laurencebarker/Andromeda_front_panel/pictures/Kjell 1st prototype/20190321_191115.jpg

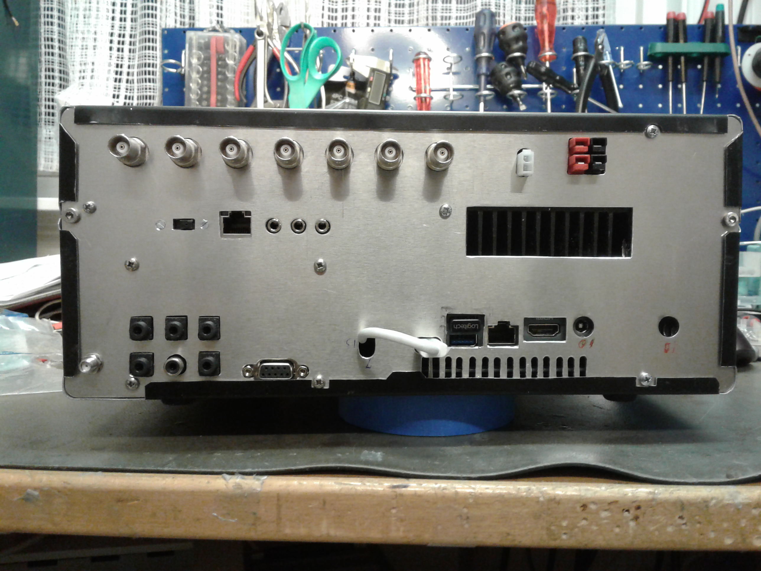
pictures/Kjell 1st prototype/20190321_191115.jpg
