laurencebarker/Andromeda_front_panel/front panel/sketch/andromeda_front_panel/readme.txt

This folder contains a sketck for a prototype of the Andromeda front panel using the ARDUINO DUE processor. 

The newer design has an Arduino Nano Every processor.

This sketch is obsolete now, and will not be maintained.
