laurencebarker/Andromeda_front_panel/front panel/documentation/Newhaven display PWM schematic.png

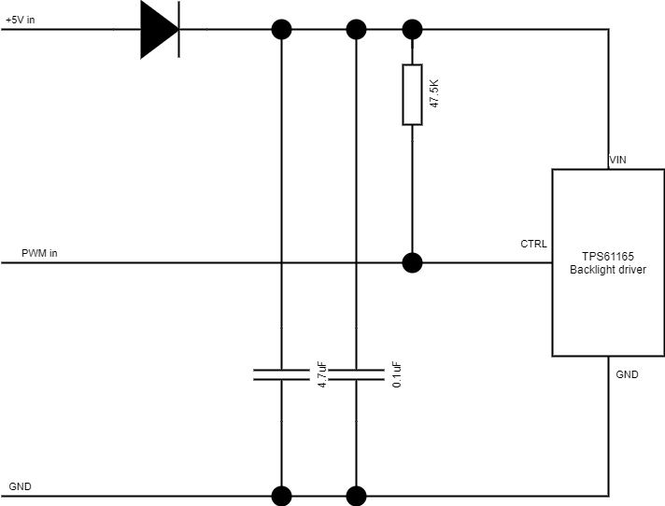
front panel/documentation/Newhaven display PWM schematic.png
