laurencebarker/Andromeda_front_panel/pictures/Kjell 1st prototype/20190321_192408.jpg

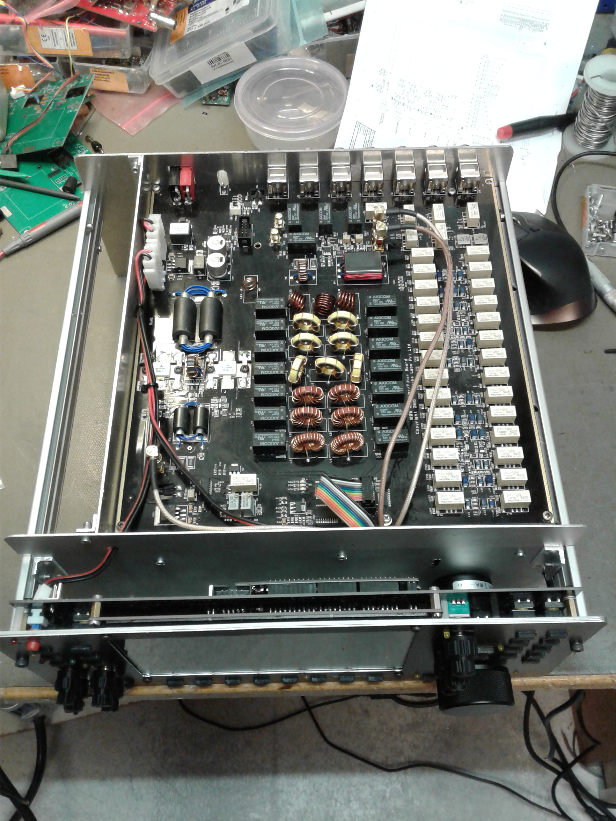
pictures/Kjell 1st prototype/20190321_192408.jpg
