laurencebarker/Andromeda_front_panel/front panel/hardware rev 5/Andromeda IO Board_ Parts_List_Nov_2019.odt

Andromeda I/O Board Parts List.

Nov. 2019

47 pcs. 10nF Size 0603

C1- C45, C47. Do not install C21, C22, C29, C30, C41

on LINE Out.

1 pcs. 2x13 26 pin Header Molex PN: 70247-2651

J1 Mouser PN: 538-70247-2651

1 pcs. 9 pin Delta Header, Female Harting PN: 09641127235 (https://www.digikey.com/product-detail/en/harting/09641127235/1195-2367-ND/3180950)

J2 DigiKey PN: 1195-2367-ND (https://www.digikey.com/product-detail/en/harting/09641127235/1195-2367-ND/3180950)

Mouser PN: 617-09-64-112-7235

1 pcs. RCA header. Pro-Signal PN: MJ-573P

J11 Farnell PN: 1267399

5 pcs. 3,5mm Stereo Jack Molex PN: 0472570001

J4-J8 Mouser PN: 538-47257-0001

DigiKey PN: WM17366-ND

1 pcs. Header1x3 Molex PN: 38-00-6293

Mouser PN: 538-38-00-6293

1 pcs. Header 1x4 Molex PN: 22-23-2042

Mouser PN: 538-22-23-2042

1 pcs. Header 2x5 10 pin header Molex PN 70246-1003

Mouser PN:538-70246-1003

26pcs. Ferrite Beads Wurth Elektronik PN: 742792514

L1-L20, L22-L27 Mouser PN: 710-742792514

DigiKey PN: 732-1643-2-ND
