laurencebarker/Andromeda_front_panel/front panel/hardware rev 5f/ANDROMEDA BOM 5F.xls

S NO. | Designator | Value | FootPrint | Qty | MFG Part No | Notes
1 | C1, C2, C3, C4, C5, C6, C7, C8, C9, C10, C11, C12, C13, C14, C15, C16, C17, C18, C22, C36 | 10NF | 805 | 20 | C0805C103K1RAC7210 | 399-17617-2-ND
2 | C19, C20, C23, C26, C29, C31, C40, C41, C42, C43, C44, C45, C46, C47 | 100NF | 805 | 14 | C0805C104M5RACTU (https://www.digikey.com/product-detail/en/kemet/C0805C104M5RACTU/399-1169-1-ND/411444) | 399-1169-1-ND (https://www.digikey.com/product-detail/en/kemet/C0805C104M5RACTU/399-1169-1-ND/411444)
3 | C21, C24, C33, C38, C48, C50 | 1uF | 805 | 6 | C0805C105K3RACTU (https://www.digikey.com/product-detail/en/kemet/C0805C105K3RACTU/399-8004-1-ND/3471727) | 399-8004-1-ND (https://www.digikey.com/product-detail/en/kemet/C0805C105K3RACTU/399-8004-1-ND/3471727)
4 | C25 | 4.7uF | 805 | 1 | CL21A475KBQNNNE (https://www.digikey.com/en/products/detail/samsung-electro-mechanics/CL21A475KBQNNNE/3886906) | 1276-1248-1-ND
5 | C27, C28 | 1NF | 805 | 2 | CC0805KRX7R9BB102 (https://www.digikey.com/product-detail/en/yageo/CC0805KRX7R9BB102/311-1127-1-ND/303037) | 311-1127-1-ND (https://www.digikey.com/product-detail/en/yageo/CC0805KRX7R9BB102/311-1127-1-ND/303037)
6 | C30 | .47uF | 805 | 1 | CC0805KKX7R8BB474 (https://www.digikey.com/product-detail/en/yageo/CC0805KKX7R8BB474/311-1364-1-ND/2103148) | 311-1364-1-ND (https://www.digikey.com/product-detail/en/yageo/CC0805KKX7R8BB474/311-1364-1-ND/2103148)
7 | C32, C34, C39, C51, C52, C53 | 10uF | 805 | 6 | GRM21BR61E106MA73L (https://www.digikey.com/product-detail/en/murata-electronics/GRM21BR61E106MA73L/490-10748-1-ND/5251352) | 490-10748-1-ND (https://www.digikey.com/product-detail/en/murata-electronics/GRM21BR61E106MA73L/490-10748-1-ND/5251352)
8 | C35 | 22uF | 2312 | 1 | T491C226M025AT (https://www.digikey.com/en/products/detail/kemet/T491C226M025AT/3724718) | 399-9736-1-ND
9 | C37 | 47uF | 2917 | 1 | T491D476K025AT (https://www.digikey.com/en/products/detail/kemet/T491D476K025AT/2336348) | 399-8391-1-ND
10 | C54 | 10uF | 1411 | 1 | T491B106M025AT (https://www.digikey.com/en/products/detail/kemet/T491B106M025AT/3724676) | 399-9721-1-ND
11 | R1 | 4K7 | 805 | 1 | RMCF0805FT4K70 (https://www.digikey.com/en/products/detail/stackpole-electronics-inc/RMCF0805FT4K70/1760659) | RMCF0805FT4K70CT-ND
12 | R2, R3, R4, R5, R6, R7, R10, R15, R16, R17, R18, R19, R20, R21, R22, R23, R24, R25, R26, R27, R28, R29, R30, R31, R32, R33, R34, R35, R36, R37, R38, R39, R40, R41, R42, R43 | 10K | 805 | 36 | RC0805FR-0710KL (https://www.digikey.com/product-detail/en/yageo/RC0805FR-0710KL/311-10-0KCRCT-ND/730482) | 311-10.0KCRCT-ND (https://www.digikey.com/product-detail/en/yageo/RC0805FR-0710KL/311-10-0KCRCT-ND/730482)
13 | R8 | 100E | 805 | 1 | CR0805-FX-1000ELF (https://www.digikey.com/en/products/detail/bourns-inc/CR0805-FX-1000ELF/3740946) | CR0805-FX-1000ELFCT-ND
14 | R9 | 470E | 805 | 1 | RC0805FR-07470RL (https://www.digikey.com/en/products/detail/yageo/RC0805FR-07470RL/727976) | 311-470CRCT-ND
15 | R12, R13, R44, R45 | 100K | 805 | 4 | RC0805FR-07100KL (https://www.digikey.com/product-detail/en/yageo/RC0805FR-07100KL/311-100KCRCT-ND/730491) | 311-100KCRCT-ND (https://www.digikey.com/product-detail/en/yageo/RC0805FR-07100KL/311-100KCRCT-ND/730491)
16 | R14 | 180K | 805 | 1 | CRGCQ0805F180K (https://www.digikey.com/product-detail/en/te-connectivity-passive-product/CRGCQ0805F180K/A129776CT-ND/8577608) | A129776CT-ND (https://www.digikey.com/product-detail/en/te-connectivity-passive-product/CRGCQ0805F180K/A129776CT-ND/8577608)
17 | R46, R47, R48, R49, R50, R51, R53, R54, R55, R56, R57, R63 | 1K2 | 805 | 11 | CRG0805F1K5 (https://www.digikey.com/product-detail/en/te-connectivity-passive-product/CRG0805F1K5/A106057CT-ND/3477701) | A106057CT-ND (https://www.digikey.com/product-detail/en/te-connectivity-passive-product/CRG0805F1K5/A106057CT-ND/3477701)
18 | R52 | 220E | 805 | 1 | RMCF0805FT220R (https://www.digikey.com/en/products/detail/stackpole-electronics-inc/RMCF0805FT220R/1760238) | RMCF0805FT220RCT-ND
19 | R59, R60 | 2K2 | 805 | 2 | RMCF0805FT2K20 (https://www.digikey.com/en/products/detail/stackpole-electronics-inc/RMCF0805FT2K20/1760345) | RMCF0805FT2K20CT-ND
20 | R61 | 620E | 805 | 1 | RMCF0805FT620R (https://www.digikey.com/en/products/detail/stackpole-electronics-inc/RMCF0805FT620R/1713293) | RMCF0805FT620RCT-ND
21 | R63 | 1K5 | 805 | 1 | RMCF0805FT1K50 (https://www.digikey.com/en/products/detail/stackpole-electronics-inc/RMCF0805FT1K50/1760652) | RMCF0805FT1K50CT-ND
22 | R62 | 3K3 | 805 | 1 | CRG0805F3K3 (https://www.digikey.com/product-detail/en/te-connectivity-passive-product/CRG0805F3K3/A106062CT-ND/3477709) | A106062CT-ND (https://www.digikey.com/product-detail/en/te-connectivity-passive-product/CRG0805F3K3/A106062CT-ND/3477709)
23 | R64 | 47E | 805 | 1 | CRG0805F47R (https://www.digikey.com/product-detail/en/te-connectivity-passive-product/CRG0805F47R/A126371CT-ND/7603426) | A126371CT-ND (https://www.digikey.com/product-detail/en/te-connectivity-passive-product/CRG0805F47R/A126371CT-ND/7603426)
24 | IC1, IC2 | MCP23017 |  | 2 | MCP23017T-E/SO | MCP23017T-E/SOCT-ND
25 | IC3 | NANO EVERY |  | 1 | ABX00033 (https://www.digikey.com/en/products/detail/arduino/ABX00033/10239972) | 1050-ABX00033-ND
26 | IC4 | LMZ22005TZ |  | 1 | LMZ22005TZX/NOPB | 296-43603-1-ND
27 | T1, T3, T4 | 2N7002K |  | 3 | 2N7002K-7 (https://www.digikey.com/product-detail/en/diodes-incorporated/2N7002K-7/2N7002K-7DICT-ND/3053305) | 2N7002K-7DICT-ND (https://www.digikey.com/product-detail/en/diodes-incorporated/2N7002K-7/2N7002K-7DICT-ND/3053305)
28 | T2 | FDD6685 |  | 1 | FDD6685 | FDD6685CT-ND
29 | ENC1, ENC3, ENC7, ENC9, ENC5, ENC11 | DUAL ENCODER |  | 6 | EC11EBB24C03 (https://au.element14.com/alps/ec11ebb24c03/encoder-dual-shaft-11mm/dp/2065025) | EC11EBB24C03 (https://au.element14.com/alps/ec11ebb24c03/encoder-dual-shaft-11mm/dp/2065025)
30 | ENC13 | HRPG-ASCA#? |  | 1 | HRPG-ASCA#19F | HRPG-ASCA#19F-ND
31 | D1, D2, D13 | RED LED |  | 3 | WP424IDT | 754-1305-ND (https://www.digikey.com/product-detail/en/kingbright/WP424IDT/754-1305-ND/1747704)
32 | D3, D6, D7, D9, D10, D11, D12 | YELLOW LED |  | 7 | WP424YDT | 754-1306-ND (https://www.digikey.com/product-detail/en/kingbright/WP424YDT/754-1306-ND/1747705)
33 | D4, D5 | GREEN LED |  | 2 | WP424GDT | 754-1304-ND (https://www.digikey.com/product-detail/en/kingbright/WP424GDT/754-1304-ND/1747703)
34 | D14 | BAS16J |  | 1 | BAS16J,115 (https://www.digikey.com/product-detail/en/nexperia-usa-inc/BAS16J-115/1727-6169-1-ND/2762666) | 1727-6169-1-ND (https://www.digikey.com/product-detail/en/nexperia-usa-inc/BAS16J-115/1727-6169-1-ND/2762666)
35 | L1-L13 | FERRITE BEAD |  | 13 | 742792514 | 732-1643-1-ND
36 | SW1-SW31 | TACTILE SWITCH |  | 31 | TL3301SPF160QG | EG1869TR-ND
37 | J1 | MIC/RJ45 |  | 1 | SS-7188V-A-NF-50 | SS-7188V-A-NF-50-ND
38 | J2, J7 | 10 PIN HEADER |  | 2 | 302-S101 | ED1543-ND (https://www.digikey.com/product-detail/en/on-shore-technology-inc/302-S101/ED1543-ND/2178422)
39 | J3 | USB-A |  | 1 | 1002-021-01000 | 1175-1265-ND
40 | J4 | USB-B |  | 1 | UJ2-BV-1-TH | 102-4000-ND
41 | J5, J6 | AUDIO |  | 2 | STX-3790-5N | 2092-STX-3790-5N-ND
42 | J8, J9, J10, J13, J14, J15, J16 | 2 PIN BERG |  | 7
43 | J11 | 4 PIN HEADER |  | 1
44 | J12, J17, J18 | 3 PIN HEADER |  | 3
45 | J16
