laurencebarker/Andromeda_front_panel/front panel/hardware/Andromeda CAT Console_rev3_BOM.odt

ULTIboard V5.71 Date : 04 May 2019 Time 18:23

File name :

---- List of Components ----

Name | Alias | Shape Comments

C1 = 100N : (C0805_W)

C2 = 1U : (C0805_W)

C3 = 100N : (C0805_W)

C4 = 10N : (C0805_W)

C5 = 100N : (C0805_W)

C6 = 100N : (C0805_W)

C7 = 10U : (C0805_W)

C8 = 100N : (C0805_W)

C9 = 1N : (C0805_W)

C10 = 100N : (C0805_W)

C11 = 100N : (C0805_W)

C12 = 100N : (C0805_W)

C13 = 100N : (C0805_W)

C14 = 10N : (C0805_W)

C15 = 10N : (C0805_W)

C16 = 10N : (C0805_W)

C17 = 10N : (C0805_W)

C18 = 10N : (C0805_W)

C19 = 10N : (C0805_W)

C20 = 10N : (C0805_W)

C21 = 10N : (C0805_W)

C22 = 10N : (C0805_W)

C23 = 10N : (C0805_W)

C24 = 10N : (C0805_W)

C25 = 10N : (C0805_W)

C26 = 10N : (C0805_W)

C27 = 10N : (C0805_W)

C28 = 10N : (C0805_W)

C29 = 10N : (C0805_W)

C30 = 10N : (C0805_W)

C31 = 10N : (C0805_W)

C32 = 100N : (C0805_W)

C33 = 100N : (C0805_W)

D1 = LED : (LED3R2_5V) 3mm diameter

D2 = LED : (LED3R2_5V) 3mm diameter

D3 = LED : (LED3R2_5V) 3mm diameter

D4 = LED : (LED3R2_5V) 3mm diameter

D5 = LED : (LED3R2_5V) 3mm diameter

D6 = LED : (LED3R2_5V) 3mm diameter

D7 = LED : (LED3R2_5V) 3mm diameter

D8 = LED : (LED3R2_5V) 3mm diameter

D9 = LED : (LED3R2_5V) 3mm diameter

D10 = LED_1 : (LED3R2_5V!1) 3mm diameter

D11 = LED : (LED3R2_5V) 3mm diameter

D12 = LED : (LED3R2_5V) 3mm diameter

D13 = LED : (LED3R2_5V) 3mm diameter

DISP1 = : (7INCH_DISPLAY!0)

DUE = : (ARDUINO_DUE)

ENC1 = HDR_5 Rotary Encoder PN:HN3808-AB-400N

Alternative PN: PNLPD 38006-600BM-24C

Alternative PN: PNG40B-6-400-2-24

+ several other.

ULTIboard V5.71 Date : 04 May 2019 Time 18:23

File name :

---- List of Components ----

Name | Alias | Shape Comments

ENC2 = - : (EC11) Dual encoder ALPS PN:EC11EBB24C03 Farnell

ENC3 = - : (EC11) Dual encoder ALPS PN:EC11EBB24C03 Farnell

ENC4 = - : (EC11) Dual encoder ALPS PN:EC11EBB24C03 Farnell

ENC5 = : (EC11) Single encoder ALPS PN:EC12E2420A2 Farnell

ENC6 = - : (EC11) Dual encoder ALPS PN:EC11EBB24C03 Farnell

ENC7 = : (EC11) Single encoder ALPS PN:EC12E2420A2 Farnell

IC1 = - : ($SO28S) MCP23017

J1 = DIGITAL : (HDR2X18) Header, Male, 2x18 pins

J2 = PWMH : (HDR1X10) Header, Male 1x10 pins

J3 = PWML : (HDR1X8) Header, Male 1x8 pins

J4 = COMMUNICATION : (HDR1X8) Header, Male 1x8 pins

J5 = POWER : (HDR1X8) Header, Male 1x8 pins

J6 = ANALOG_IN : (HDR1X8) Header, Male 1x8 pins

J7 = ADCH : (HDR1X8) Header, Male 1x8 pins

J8 = HDR_2 : (HDR1X2) Header, Male 1x2 pins

J9 = HDR_3 : (HEADER1X3) Header, Male 1x3 pins

J10 = HDR_10 : (HDR2X5) Header, Male 2x5 pins

J11 = HDR_2 : (HDR1X2) Header, Male 1x2 pins

J12 = HDR_10 : (RJ45!0) RJ45 PN:AE10392-ND Prod:Assman DigiKey

J13 = HDR_10 : (HDR2X5) Header, Male, 2x5 pins

J14 = HDR_6 : (USB_A_V) PN:1002-021-01000 Prod CnCTech DigiKey

Alt PN:RND 205-00660 Prod: RND Elfa Distrelec

J15 = HDR_6 : (HDR2X3) Header. Male 2x3

J16 = HDR_4 : (MOLEX_WM17) 3,5 mm Stereo Jack PN:47257-0001 DigiKey

J17 = HDR_4 : (MOLEX_WM17) 3,5 mm Stereo Jack PN:47257-0001 DigiKey

J18 = HDR_10 : (HDR2X5) Header, Male 2x5 Pins

J19 = HDR_2 : (HDR1X2) Header, Male 1x2 Pins

J20 = HDR_2 : (HDR1X2) Header, Male 1x2 Pins

L1 = FERR_B : (TAN_A_W) Ferrite Bead, PN:742792514 (https://www.digikey.com/product-detail/en/wurth-electronics-inc/742792514/732-1643-2-ND/1639047) Prod:Wurth DigiKey

L2 = FERR_B : (TAN_A_W) Ferrite Bead, PN:742792514 (https://www.digikey.com/product-detail/en/wurth-electronics-inc/742792514/732-1643-2-ND/1639047) Prod:Wurth DigiKey

L3 = FERR_B : (TAN_A_W) Ferrite Bead, PN:742792514 (https://www.digikey.com/product-detail/en/wurth-electronics-inc/742792514/732-1643-2-ND/1639047) Prod:Wurth DigiKey

L4 = FERR_B : (TAN_A_W) Ferrite Bead, PN:742792514 (https://www.digikey.com/product-detail/en/wurth-electronics-inc/742792514/732-1643-2-ND/1639047) Prod:Wurth DigiKey

L5 = FERR_B : (TAN_A_W) Ferrite Bead, PN:742792514 (https://www.digikey.com/product-detail/en/wurth-electronics-inc/742792514/732-1643-2-ND/1639047) Prod:Wurth DigiKey

L6 = FERR_B : (TAN_A_W) Ferrite Bead, PN:742792514 (https://www.digikey.com/product-detail/en/wurth-electronics-inc/742792514/732-1643-2-ND/1639047) Prod:Wurth DigiKey

L7 = FERR_B : (TAN_A_W) Ferrite Bead, PN:742792514 (https://www.digikey.com/product-detail/en/wurth-electronics-inc/742792514/732-1643-2-ND/1639047) Prod:Wurth DigiKey

L8 = FERR_B : (TAN_A_W) Ferrite Bead, PN:742792514 (https://www.digikey.com/product-detail/en/wurth-electronics-inc/742792514/732-1643-2-ND/1639047) Prod:Wurth DigiKey

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

SW34 = - : (SPSD_6X6) PN:TL3301SPF260QG Prod: E_Switch DigiKey

SW35 = - : (SPSD_6X6) PN:TL3301SPF260QG Prod: E_Switch DigiKey

SW36 = - : (SPSD_6X6) PN:TL3301SPF260QG Prod: E_Switch DigiKey

SW37 = - : (SPSD_6X6) PN:TL3301SPF260QG Prod: E_Switch DigiKey

SW38 = - : (SPSD_6X6) PN:TL3301SPF260QG Prod: E_Switch DigiKey

SW39 = - : (SPSD_6X6) PN:TL3301SPF260QG Prod: E_Switch DigiKey

SW41 = - : (SPSD_6X6) PN:TL3301SPF260QG Prod: E_Switch DigiKey

SW42 = - : (SPSD_6X6) PN:TL3301SPF260QG Prod: E_Switch DigiKey

SW43 = - : (SPSD_6X6) PN:TL3301SPF260QG Prod: E_Switch DigiKey

SW44 = - : (SPSD_6X6) PN:TL3301SPF260QG Prod: E_Switch DigiKey

SW45 = - : (SPSD_6X6) PN:TL3301SPF260QG Prod: E_Switch DigiKey

SW46 = - : (PBSW!0) PN:B3F-4050 Prod: OMRON DigiKey

SW48 = - : (PBSW!0) PN:B3F-4050 Prod: OMRON DigiKey

SW49 = - : (PBSW!0) PN:B3F-4050 Prod: OMRON DigiKey

SW50 = - : (PBSW!0) PN:B3F-4050 Prod: OMRON DigiKey

SW51 = - : (SPSD_6X6) PN:TL3301SPF260QG Prod: E_Switch DigiKey

SW53 = - : (SPSD_6X6) PN:TL3301SPF260QG Prod: E_Switch DigiKey

SW54 = - : (SPSD_6X6) PN:TL3301SPF260QG Prod: E_Switch DigiKey

SW55 = - : (SPSD_6X6) PN:TL3301SPF260QG Prod: E_Switch DigiKey

SW56 = - : (PBSW!0) PN:B3F-4050 Prod: OMRON DigiKey

SW58 = - : (PBSW!0) PN:B3F-4050 Prod: OMRON DigiKey

SW59 = - : (PBSW!0) PN:B3F-4050 Prod: OMRON DigiKey

SW60 = - : (SPSD_6X6) PN:TL3301DF160QG Prod: E_Switch DigiKey

SW61 = - : (SPSD_6X6) PN:TL3301DF160QG Prod: E_Switch DigiKey

SW62 = - : (SPSD_6X6) PN:TL3301DF160QG Prod: E_Switch DigiKey

SW63 = - : (PBSW!0) PN:B3F-4050 Prod: OMRON DigiKey

SW64 = - : (SPSD_6X6) PN:TL3301DF160QG Prod: E_Switch DigiKey

T1 = 2N7002K_T/R : ($FET_2N7002!0)
