laurencebarker/Andromeda_front_panel/front panel/documentation/thetis fast tune calculator.xlsx

Variable rate encoder
encoder pulses per second | 480
update rate | 20 | ms
turn rate | 1 | rev/sec
steps/tick | 9.6
a | 0.8
b | 0.04
c | 0.005
X | Y |  | Y=ax+bx2
0 | 0
1 | 1
2 | 2
3 | 3
4 | 4
5 | 6
6 | 7
7 | 9
8 | 12
9 | 14
10 | 17
11 | 20
12 | 24
12 | 24
13 | 28
14 | 33
15 | 38
16 | 44
17 | 50
18 | 57
19 | 64
20 | 72
