laurencebarker/Andromeda_front_panel/(threads)

Thread 1 (2019-12-01):

Great project!

UN7RX, 2019-12-01:
Sorry, but I just could not thank Lawrence G8NJJ and you, Kjell LA2NI, for your beautiful designs!
I don’t understand why so few hams know about them, this is a wonderful job! Many thanks!

UN7RX, 2019-12-14:
My DDU DUC transceiver does not support Thetis, I use PowerSDR. There fore, I will use the option with Arduino DUE and version 2 or 3. There is a very useful thing in the Odin project - the Nextion display. Can I turn on the display in the Andromeda project in any way?

hb9trt, 2022-04-05:
Hi Robert,
I tried to send you an email, but I could not find any. So I try to explain something about the andromeda controller. It's not possible to use a Nextion with the andromeda controller, because this controller has no own gui. It's "only" a translation from the panel emelments (knobs, encoders) to CAT commands which can only be decoded with the latest Thetis version. The display, which you can see in different projects is connected by HDMI with an internal PC in the TRX (for example an INtel NUC). Also the touchscreen is connected directly with USB to the PC. So no signals (Video and Touch) is conneced with the andreomeda controllers arduino. The only connection to the display is the PWM entry for controlling the brightness. So it makes no sense to connect an Nextion display to this project.
I made a complete TRX built from an Odyssey-2 DDC/DUC with a HFPU 100, some transverters for higher Bands and an internal I7 NUC. Jörg Saure shows my project on his website if you would like to see more.

https://saure.org/cq-nrw/2021/05/29/odyssey-2-eigenbau-mit-andromeda-frontpanel-von-reto-hb9trt/

If you have an DDC/DUC not working with Thetis, the andromeda project cannot be used.

Thread 2 (2019-12-02):

PCB editor

UN7RX, 2019-12-02:
Good day In which program was the circuit board developed? Can I see the source code? I want to slightly change the location of the components.
When importing gerber, some of the information is lost ((

Thread 3 (2020-02-27):

PCB for Andromeda SDR Radio_v3.fpd

DH1KLM, 2020-02-27:
It's more of a request than an issue.
Are there also matching Gerber files (nothing found) for the Andromeda SDR Radio_v3.fpd front panel,
like it is in harware rev 4. I also could not find a matching Andromeda SDR Radio_v5.fpd for Andromeda Front Panel Rev5e_060220.

Please help.
Thank you

Closed 2020-03-17.

Thread 4 (2020-12-16):

Thanks for this interesting Project

hb9trt, 2020-12-16:
I would like to test if the Andromeda frontpanel works together with my former built Odyssey-2. I think it will work.

So I tried to compile the Sketch for Arduino Nano Every and got some errors:

'class PORTCClass' has no member named 'IN'

the whole error output of the compiler is here:

sketch\opticalencoder.cpp: In function 'void InitOpticalEncoder()':
opticalencoder.cpp:68:22: error: 'class PORTCClass' has no member named 'IN'
   GPinState = (PORTC.IN & VENCODERPINS) >> 2;           // bits 3:2
                      ^~
opticalencoder.cpp:76:9: error: 'class PORTCClass' has no member named 'PIN4CTRL'
   PORTC.PIN4CTRL = (PORT_PULLUPEN_bm | PORT_ISC_BOTHEDGES_gc);            // pullup, both edges interrupt
         ^~~~~~~~
opticalencoder.cpp:77:9: error: 'class PORTCClass' has no member named 'PIN5CTRL'
   PORTC.PIN5CTRL = (PORT_PULLUPEN_bm | PORT_ISC_BOTHEDGES_gc);            // pullup, both edges interrupt
         ^~~~~~~~
sketch\opticalencoder.cpp: In function 'void __vector_24()':
opticalencoder.cpp:102:23: error: 'class PORTCClass' has no member named 'IN'
   InputValue = (PORTC.IN & VENCODERPINS) >> 2;            // bits 3:2
                       ^~
opticalencoder.cpp:103:9: error: 'class PORTCClass' has no member named 'INTFLAGS'
   PORTC.INTFLAGS = 0b00110000;                            // clear interrupt flags
         ^~~~~~~~
sketch\tiger.cpp:48:1: warning: narrowing conversion of '10000000000' from 'long long int' to 'long int' inside { } [-Wnarrowing]
 };
 ^
sketch\tiger.cpp:48:1: warning: overflow in implicit constant conversion [-Woverflow]
sketch\tiger.cpp:48:1: warning: narrowing conversion of '100000000000' from 'long long int' to 'long int' inside { } [-Wnarrowing]
sketch\tiger.cpp:48:1: warning: overflow in implicit constant conversion [-Woverflow]
sketch\tiger.cpp:48:1: warning: narrowing conversion of '1000000000000' from 'long long int' to 'long int' inside { } [-Wnarrowing]
sketch\tiger.cpp:48:1: warning: overflow in implicit constant conversion [-Woverflow]
sketch\tiger.cpp:48:1: warning: narrowing conversion of '10000000000000' from 'long long int' to 'long int' inside { } [-Wnarrowing]
sketch\tiger.cpp:48:1: warning: overflow in implicit constant conversion [-Woverflow]
sketch\tiger.cpp:67:1: warning: ISO C++ forbids converting a string constant to 'char*' [-Wwrite-strings]
 };
 ^
sketch\tiger.cpp:67:1: warning: ISO C++ forbids converting a string constant to 'char*' [-Wwrite-strings]
sketch\tiger.cpp:67:1: warning: ISO C++ forbids converting a string constant to 'char*' [-Wwrite-strings]
sketch\tiger.cpp:67:1: warning: ISO C++ forbids converting a string constant to 'char*' [-Wwrite-strings]
sketch\tiger.cpp:67:1: warning: ISO C++ forbids converting a string constant to 'char*' [-Wwrite-strings]
sketch\tiger.cpp:67:1: warning: ISO C++ forbids converting a string constant to 'char*' [-Wwrite-strings]
sketch\tiger.cpp:67:1: warning: ISO C++ forbids converting a string constant to 'char*' [-Wwrite-strings]
exit status 1
'class PORTCClass' has no member named 'IN'

there are also some other errors. I think I did something wrong, but I don' know what. I added the Libraries 'DueFlashStorage', Encoder, DueTimer.

But I'm not sure if this is only for Arduiono Due. Also the standard library wire.h isn't installed, which should be installed if the board (here the Arduino Nano Every) is installed.

vy 73
Reto

hb9trt, 2020-12-16:
If I coment out some parts of the code in opticalencoder.cpp the project can be compiled.

#ifdef HIRESOPTICALENCODER
  PORTC.PIN4CTRL = (PORT_PULLUPEN_bm | PORT_ISC_RISING_gc);               // pullup, rising edge interrupt
#else
  // for low res (Broadcom type) encoders, get an interrupt on every edge
**//  PORTC.PIN4CTRL = (PORT_PULLUPEN_bm | PORT_ISC_BOTHEDGES_gc);**            // pullup, both edges interrupt
**//  PORTC.PIN5CTRL = (PORT_PULLUPEN_bm | PORT_ISC_BOTHEDGES_gc);**            // pullup, both edges interrupt
#endif
}

//
// VFO encoder pin interrupt handler
// this works one of two ways depending on the attached encoder
// for a broadcom type encoder - use both edges; find 4 bits from 2 bits current state and 2 bits previous state, and look up
// for a high res encoder at just one interrupt per pulse - use int on one edge and use the sense of the other to set direction.
//
ISR(PORTC_PORT_vect)
{
  byte InputValue;
  signed char Increment;

#ifdef HIRESOPTICALENCODER                                // on interrupt - read the non interrupting pin to set direction
  InputValue = PORTC.IN & VENCODERDIRPIN;
  PORTC.INTFLAGS = 0b00010000;                            // clear interrupt flags
  if (InputValue)
    Increment = 1;
  else
    Increment = -1;
#else
  **//  InputValue = (PORTC.IN & VENCODERPIN) >> 2;**            // bits 3:2
  **//  PORTC.IN = 0b00110000;**                            // clear interrupt flags
  GPinState = (GPinState >> 2) | InputValue;              // now have new bits in 3:2, old bits in 1:0
  Increment = StepsLookup[GPinState];
#endif

If I'm a better programmer... I could find the reason.

vy 73
Reto

Thread 6 (2022-04-04):

Type Arduino

UN7RX, 2022-04-04:
Is it possible to replace Arduino Nano Every with another type of arduino? Arduino Mega, Arduino nano, Arduino Mini, Arduino Uno? I have a big problem with acquiring Every ((

Thanks!

hb9trt, 2022-04-04:
I think basically this should work, but you have to modify the sketch to the used arduino. Also the footprint of the arduino should be the same as the every, because it will bi plugged in to the andromeda board. If you take a mega you have to wire all manualy.
But the best thing will be to have a look after an every. So you can be sure, that all works well. Also the timings could be a problem, if you take another version arduino, but I'm not sure if this is really problematic here.
