laurencebarker/Andromeda_front_panel/front panel/hardware rev 5f/Andromeda Front Panel Rev5f_02_11_20.pdf

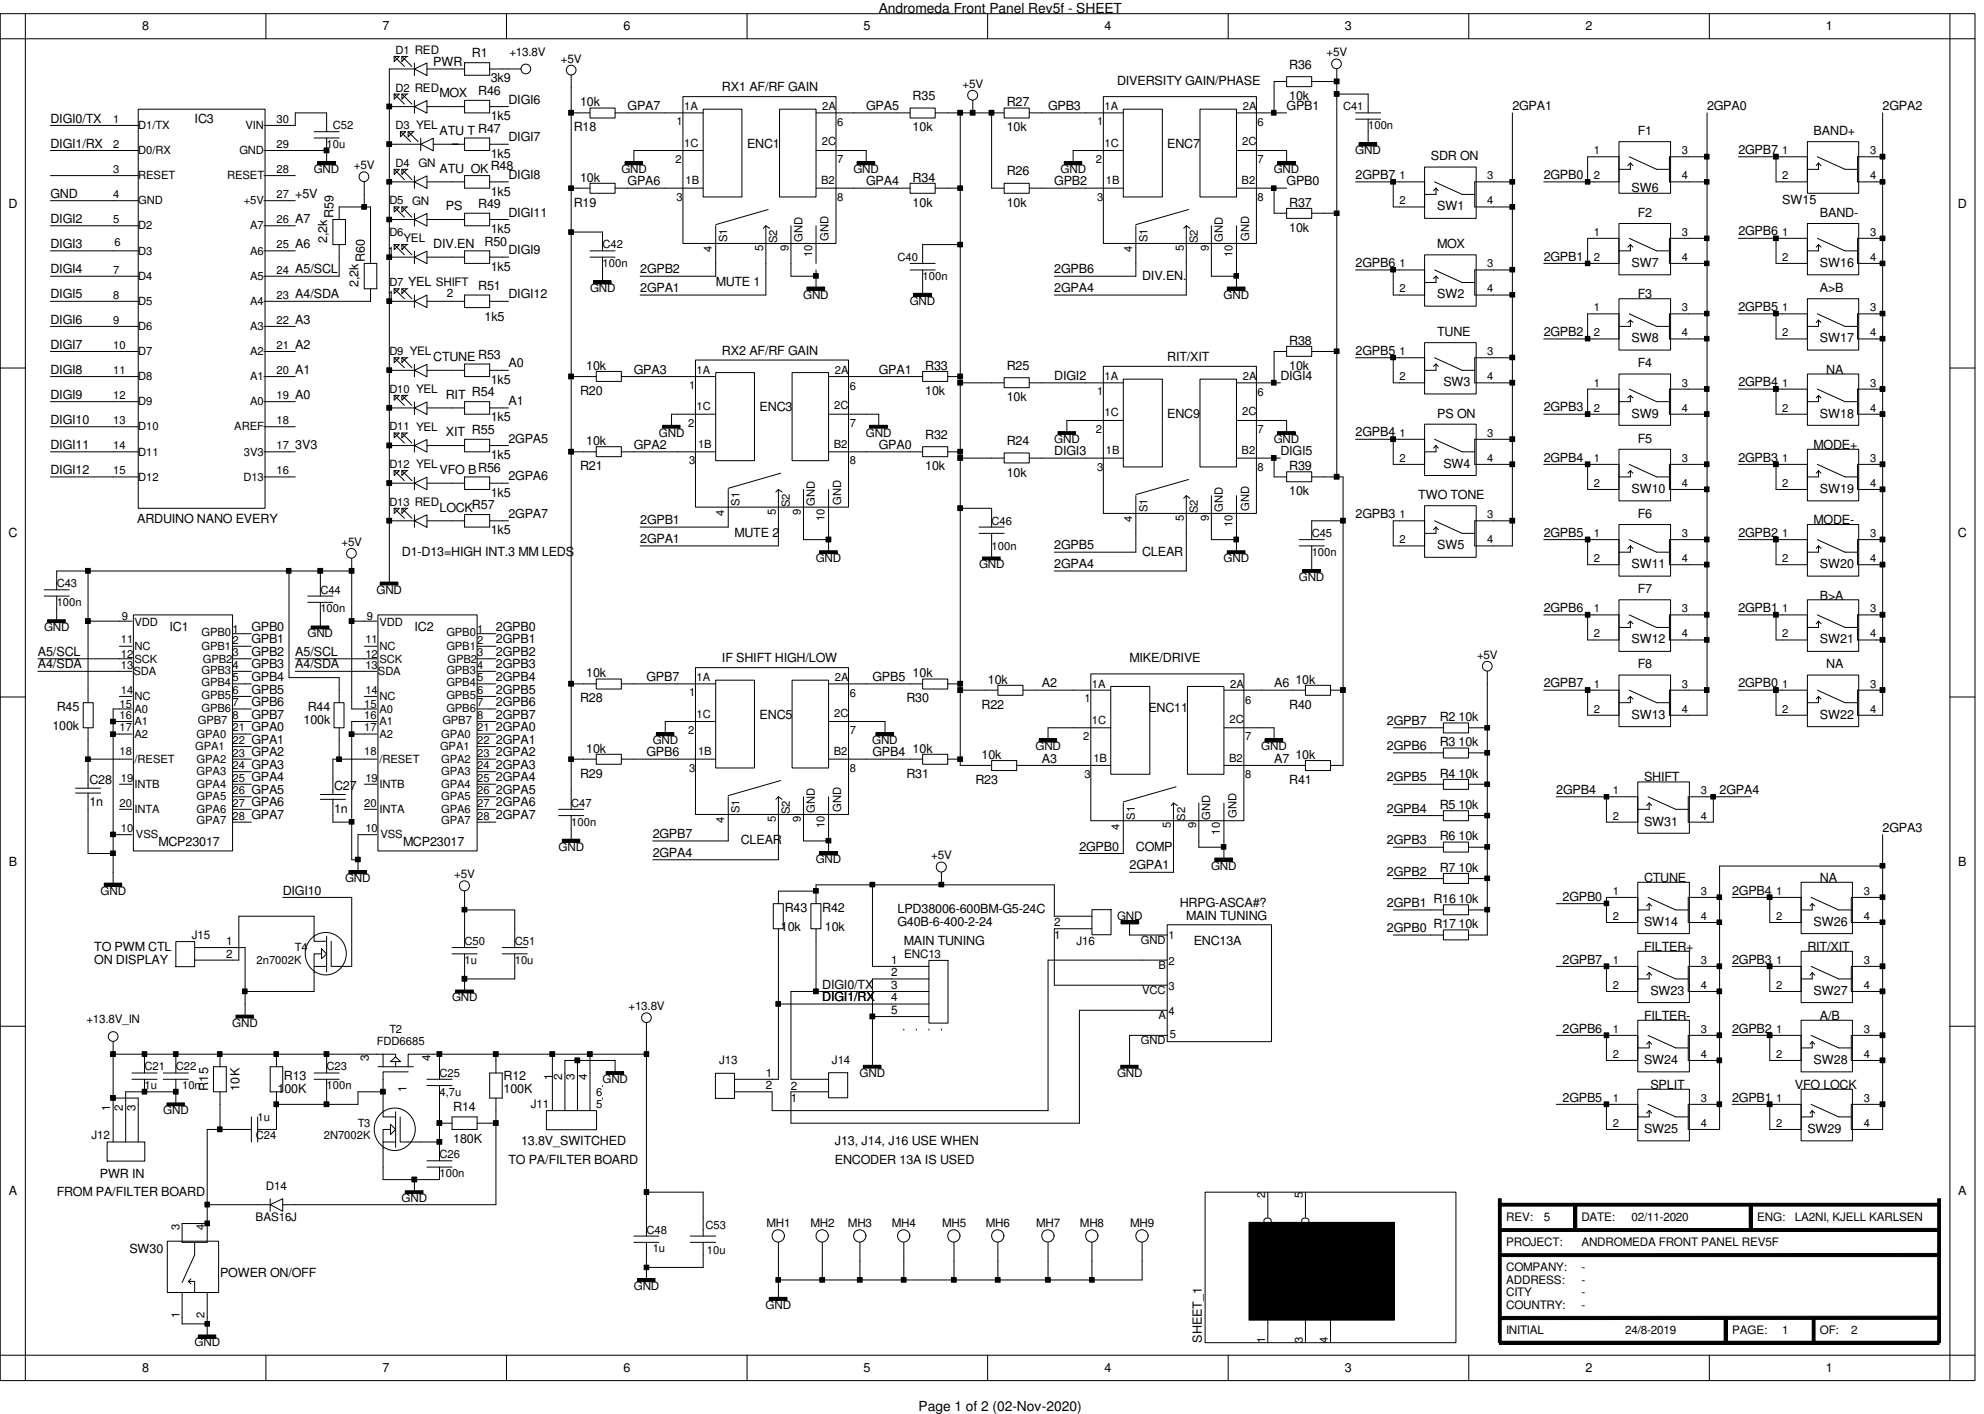
[picture p17: page 1]

Andromeda Front Panel Rev5f - SHEET

D1-D13=HIGH INT.3 MM LEDS

13.8V_SWITCHED
TO PA/FILTER BOARD

FROM PA/FILTER BOARD

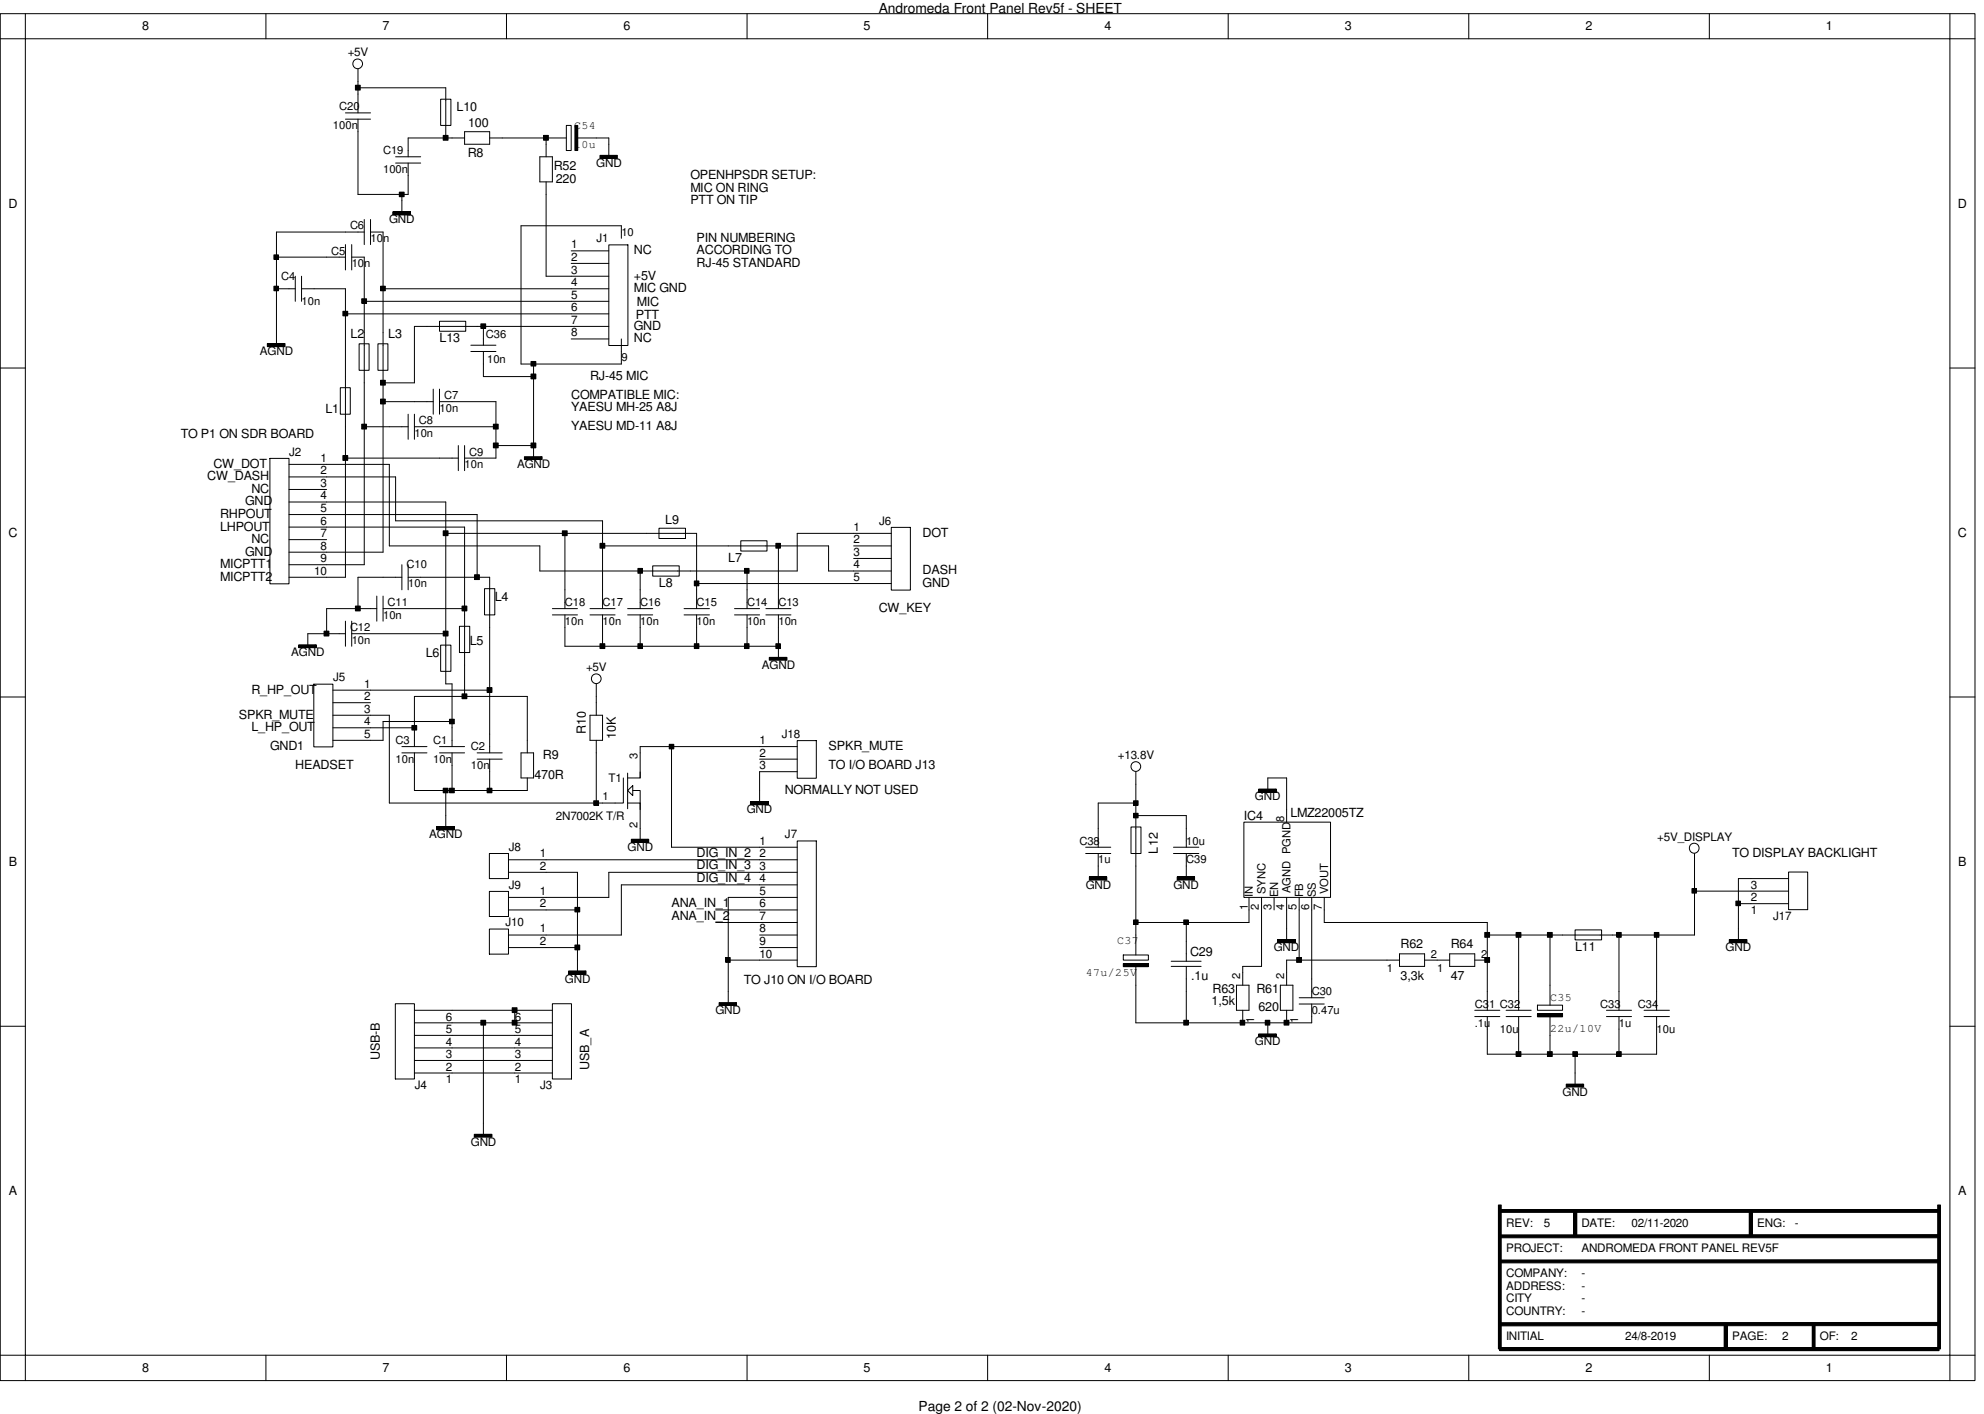
[picture p18: page 2]

Andromeda Front Panel Rev5f - SHEET

TO P1 ON SDR BOARD
