laurencebarker/Andromeda_front_panel/front panel/hardware rev 5/Andromeda Front Panel_Schematics_ Rev5e_06_.pdf

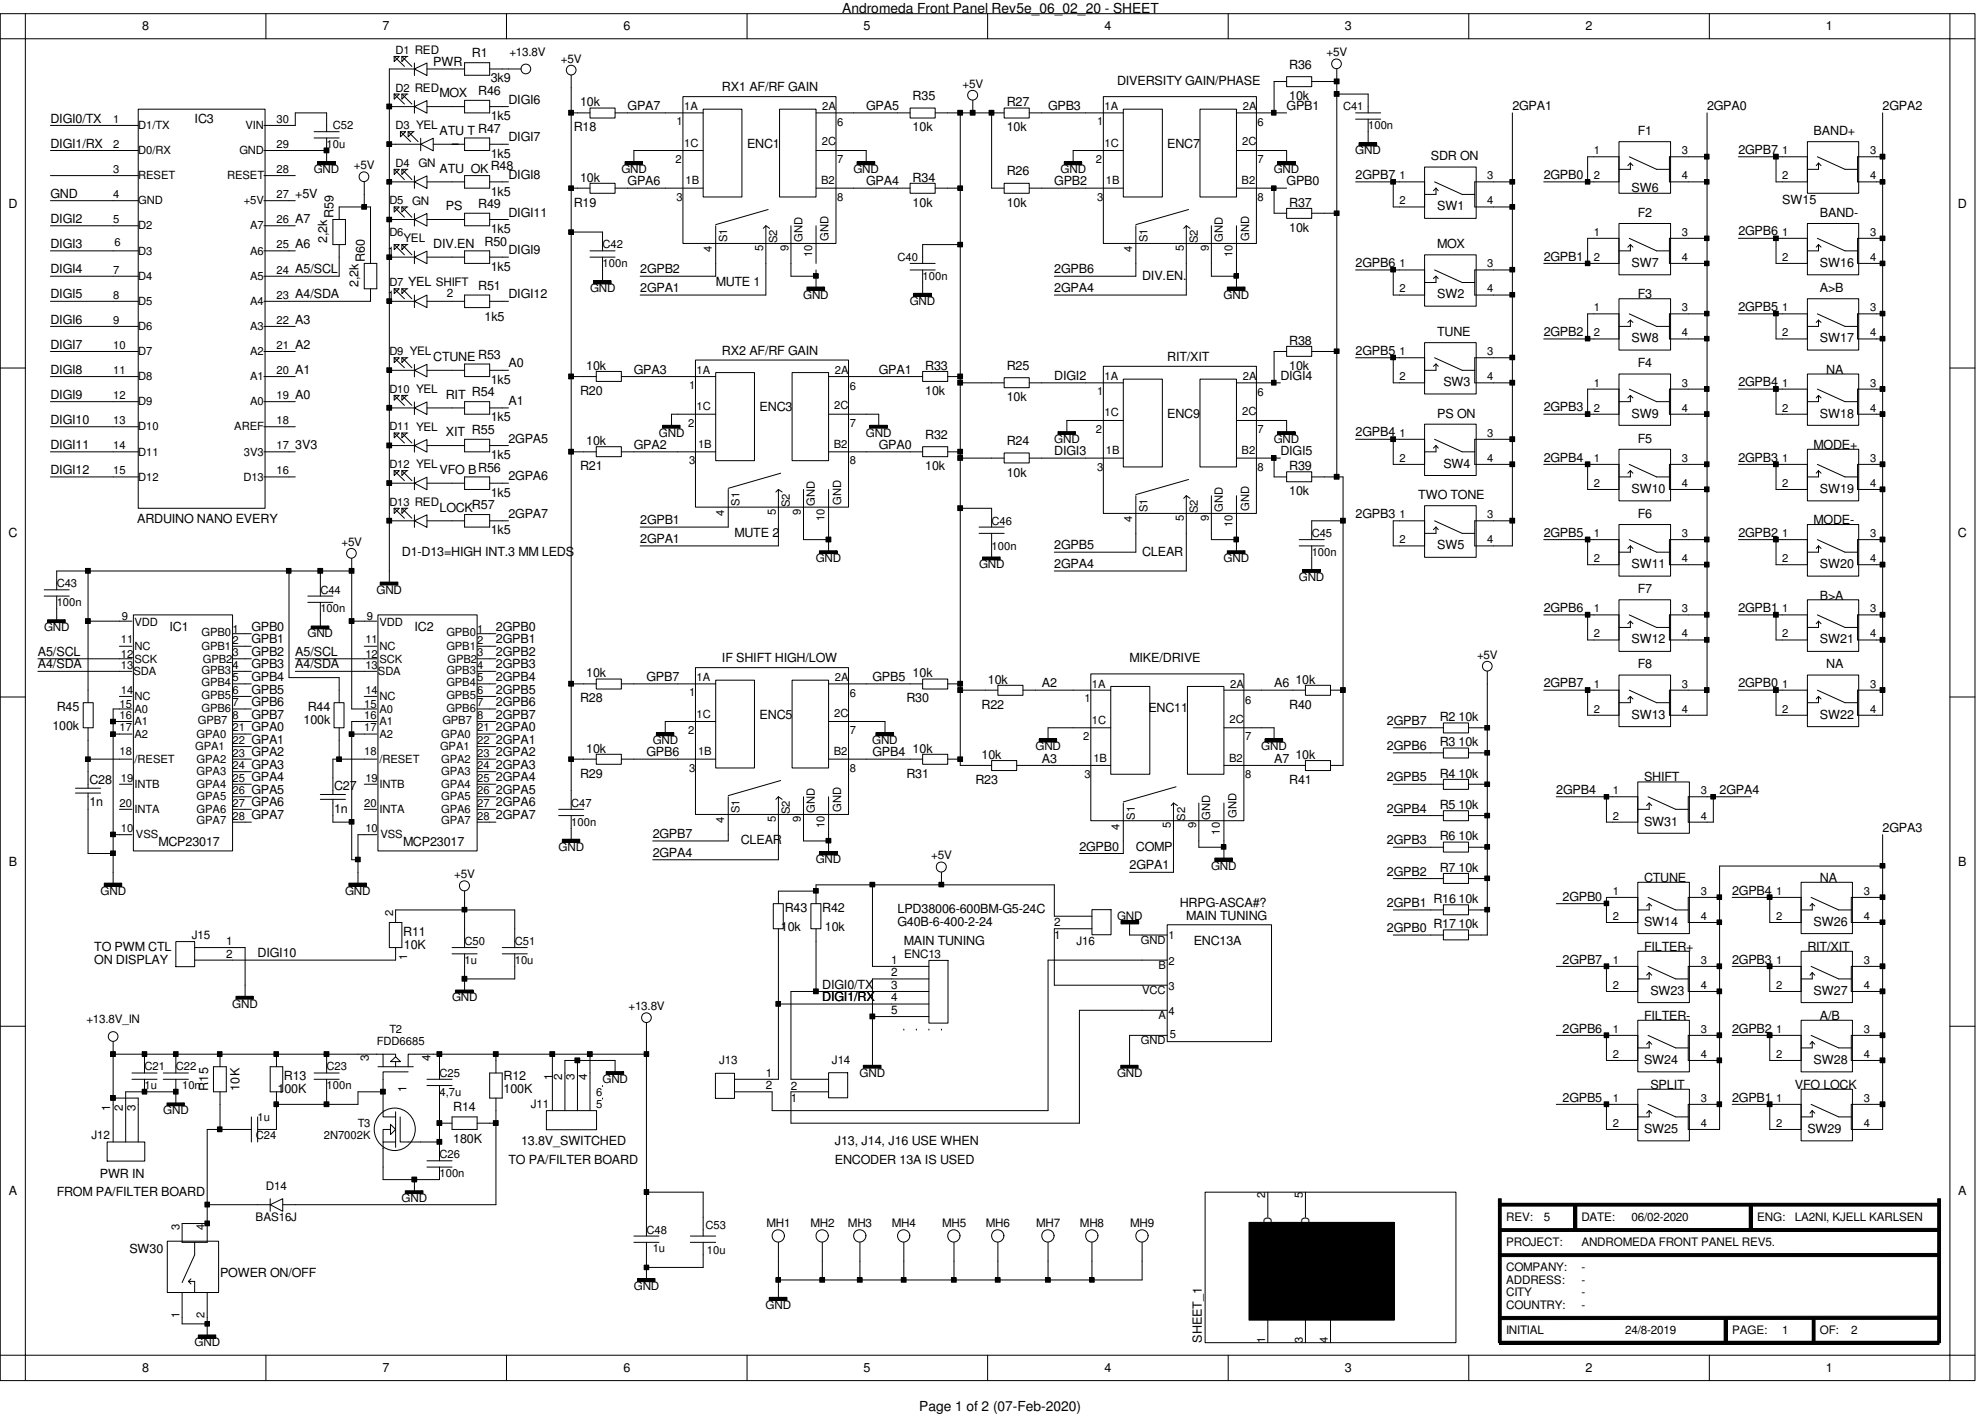
[picture p19: page 1]

Andromeda Front Panel Rev5e_06_02_20 - SHEET

D1-D13=HIGH INT.3 MM LEDS

13.8V_SWITCHED
TO PA/FILTER BOARD

FROM PA/FILTER BOARD

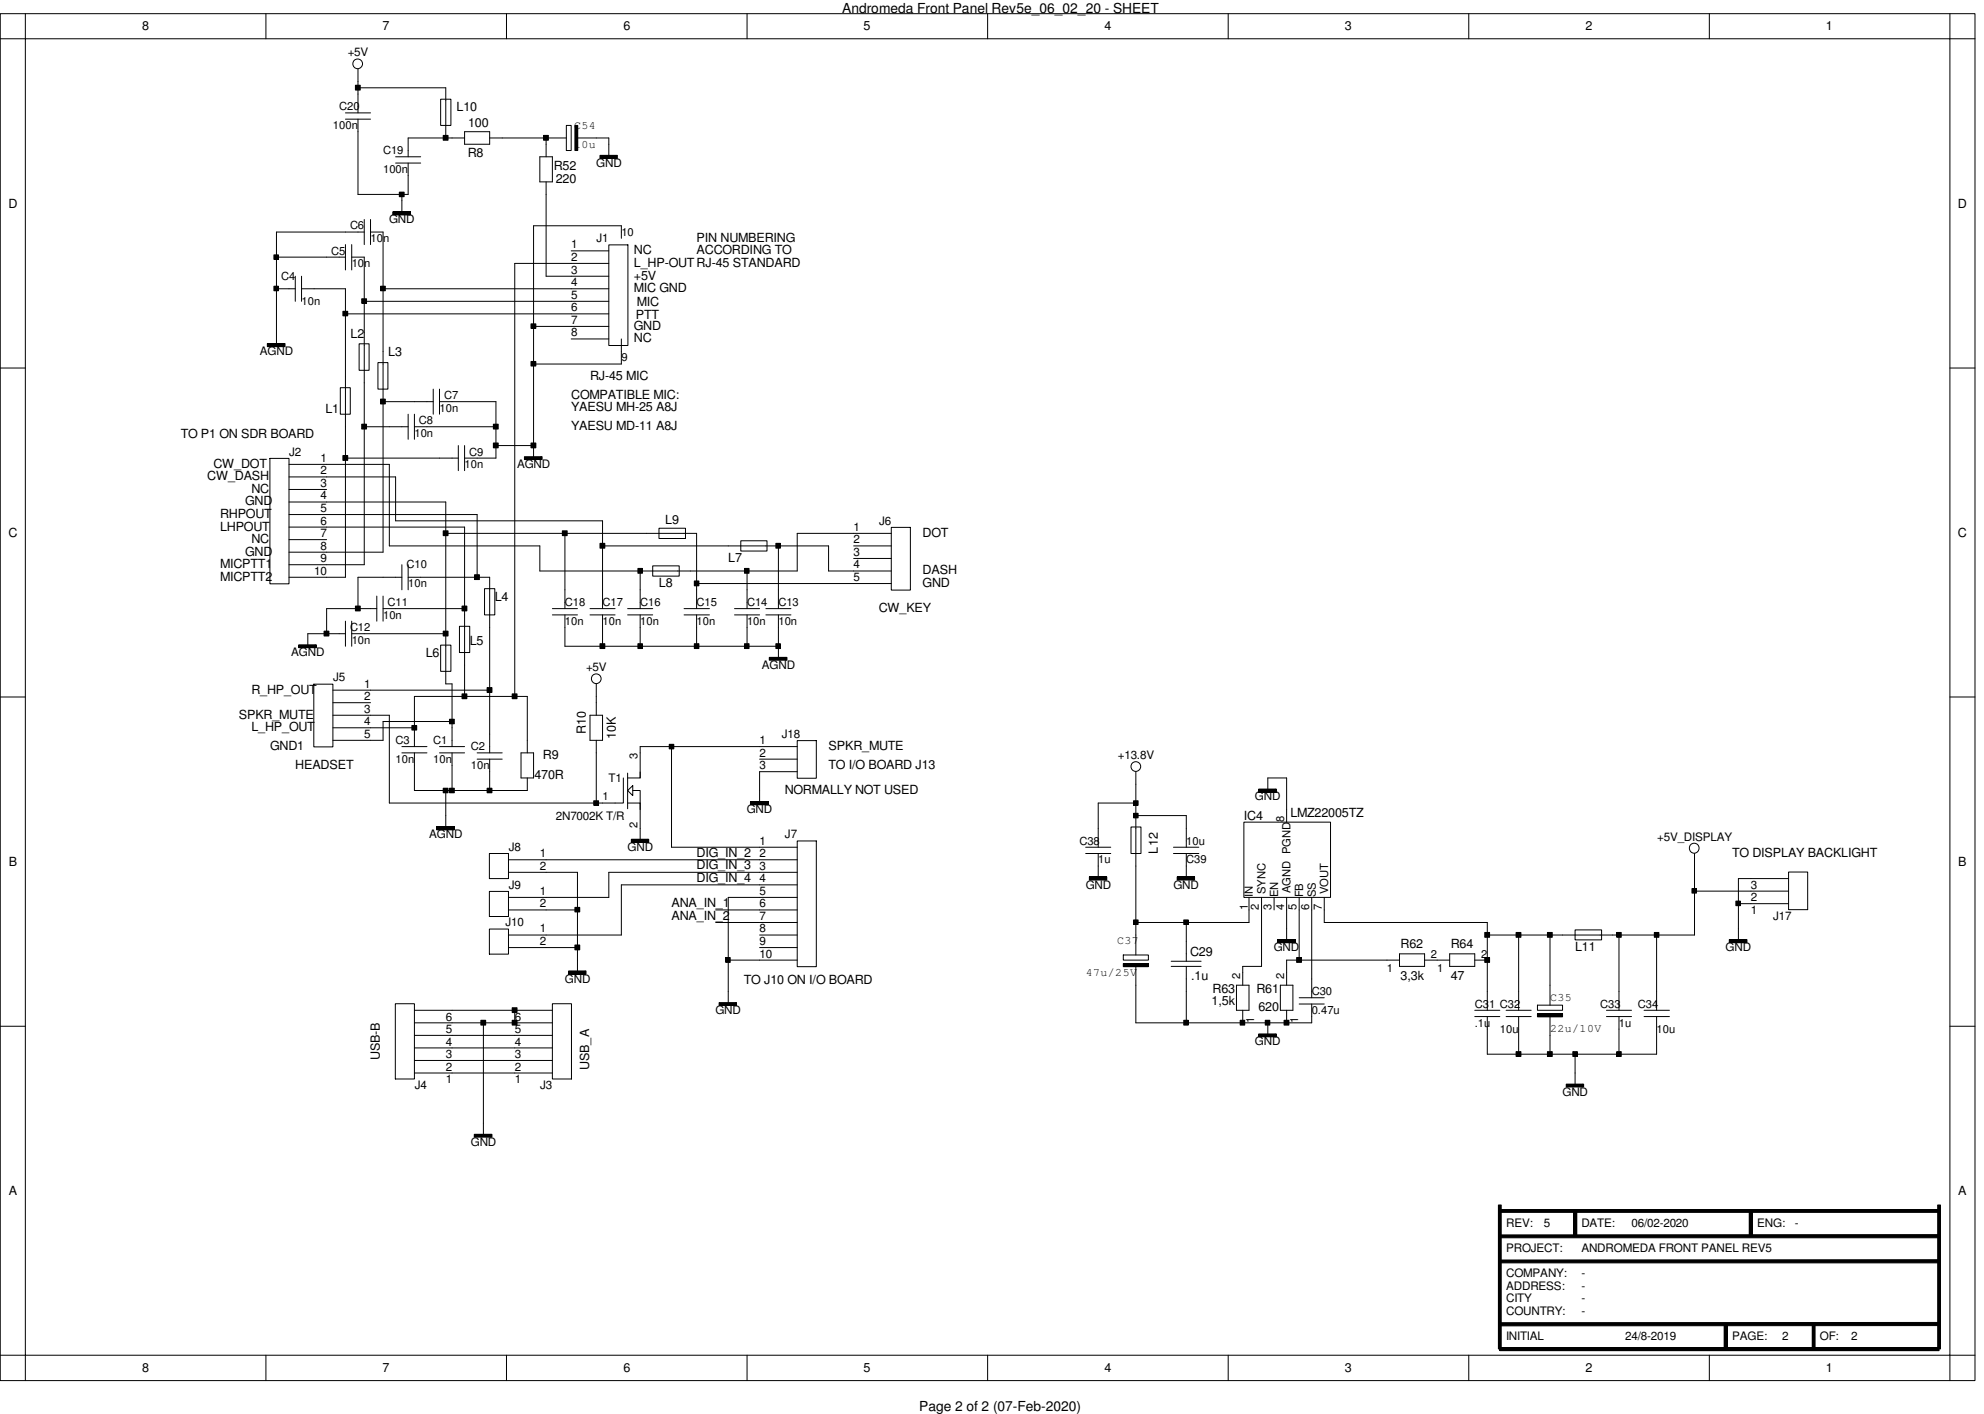
[picture p20: page 2]

Andromeda Front Panel Rev5e_06_02_20 - SHEET

TO P1 ON SDR BOARD
