laurencebarker/Andromeda_front_panel/front panel/hardware rev 5/Andromeda I-O Board_101019.pdf

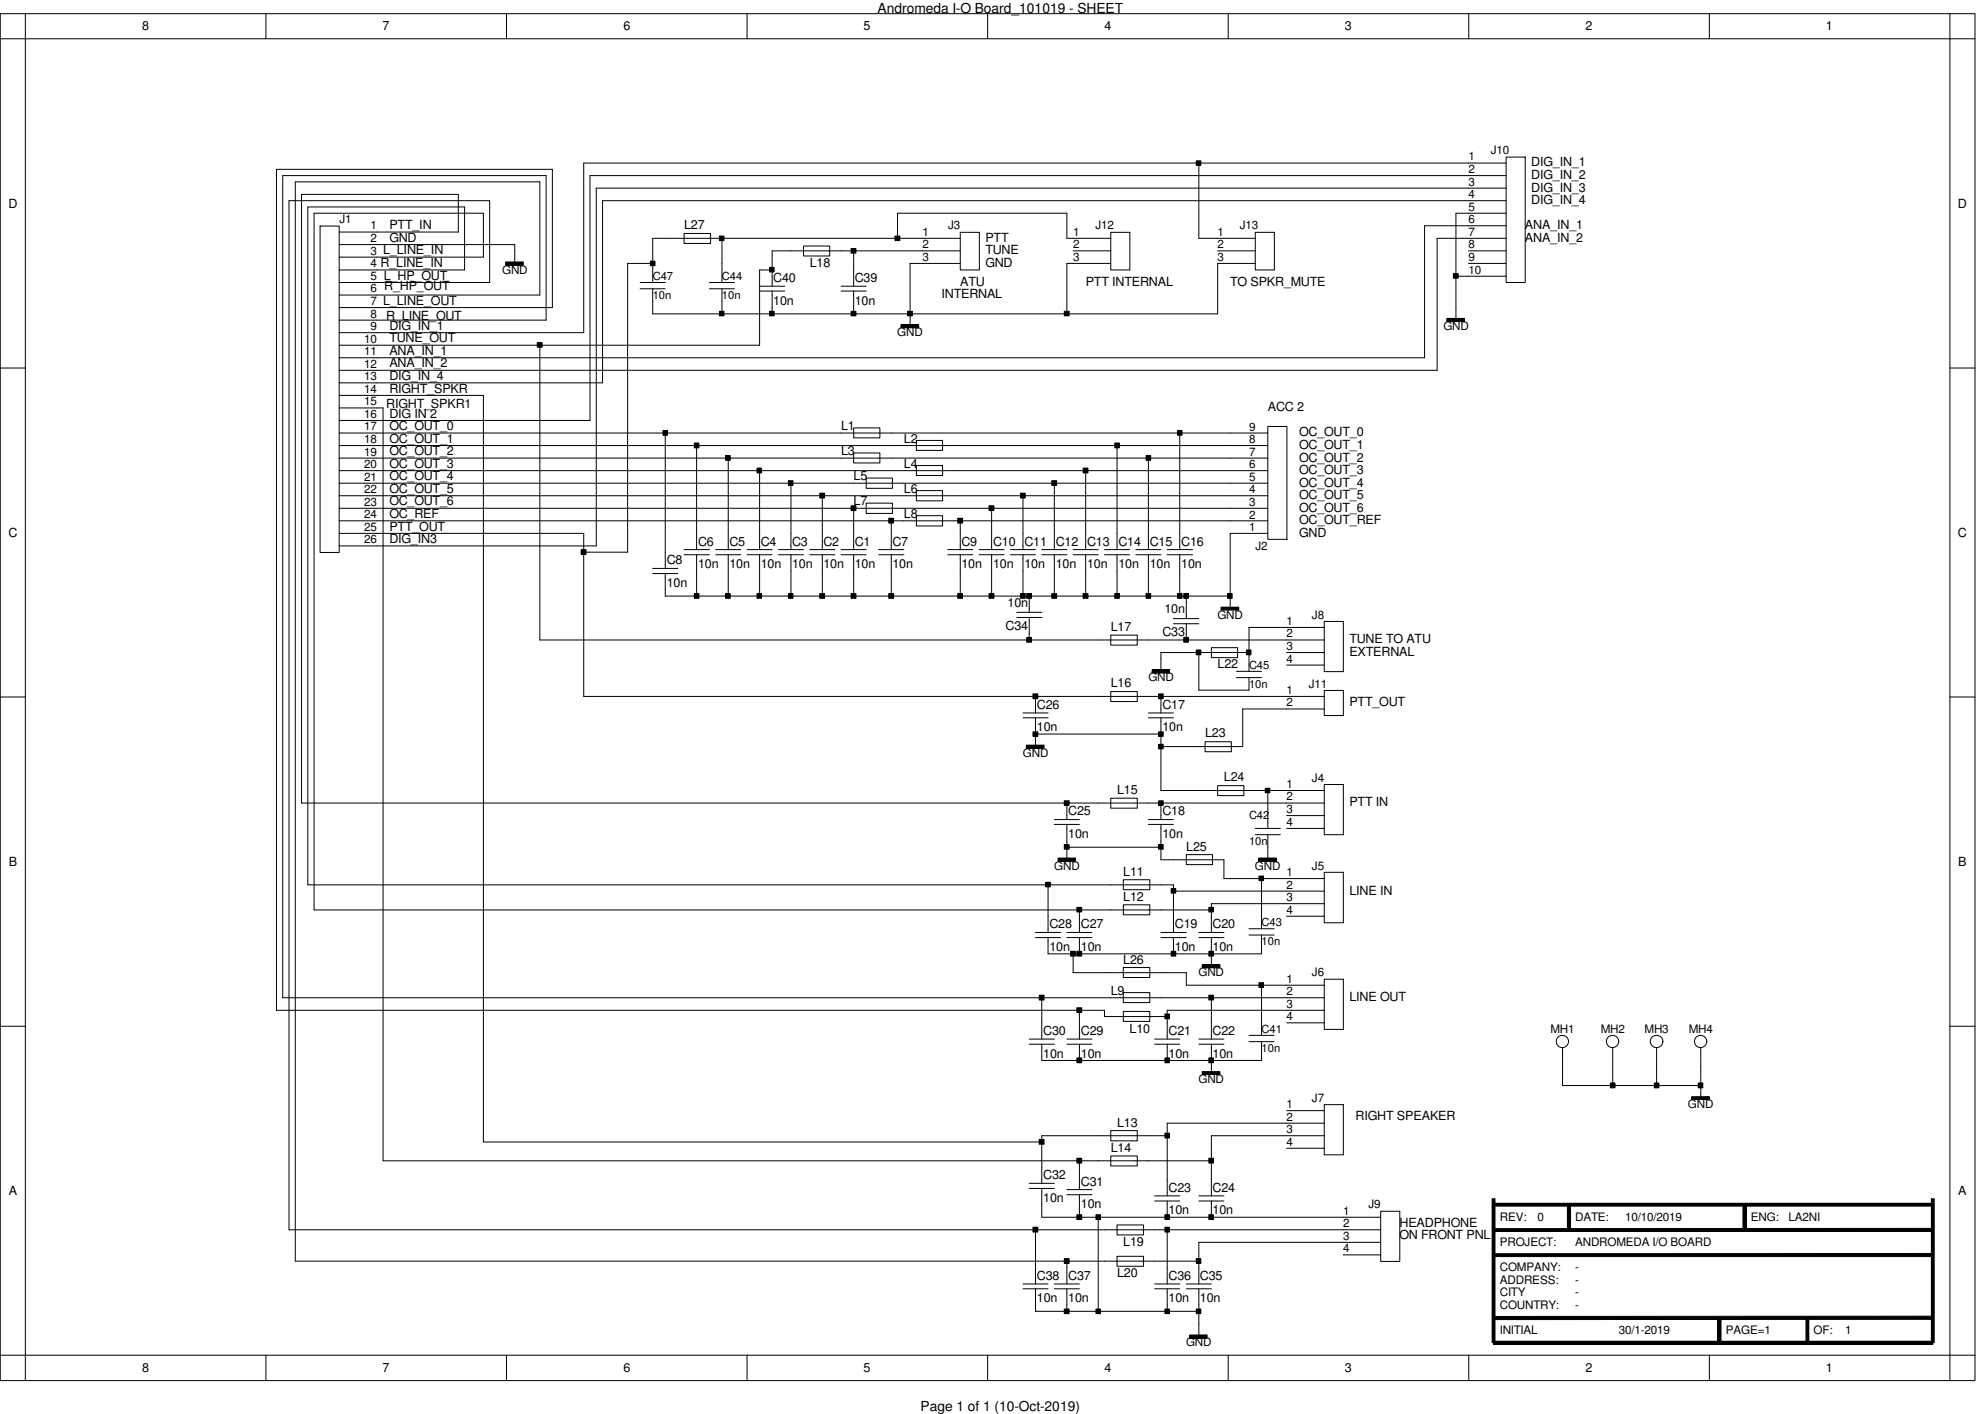
[picture p21: page 1]
