laurencebarker/Andromeda_front_panel/front panel/1st prototype hardware/Andromeda CAT Console prototype layout.pdf

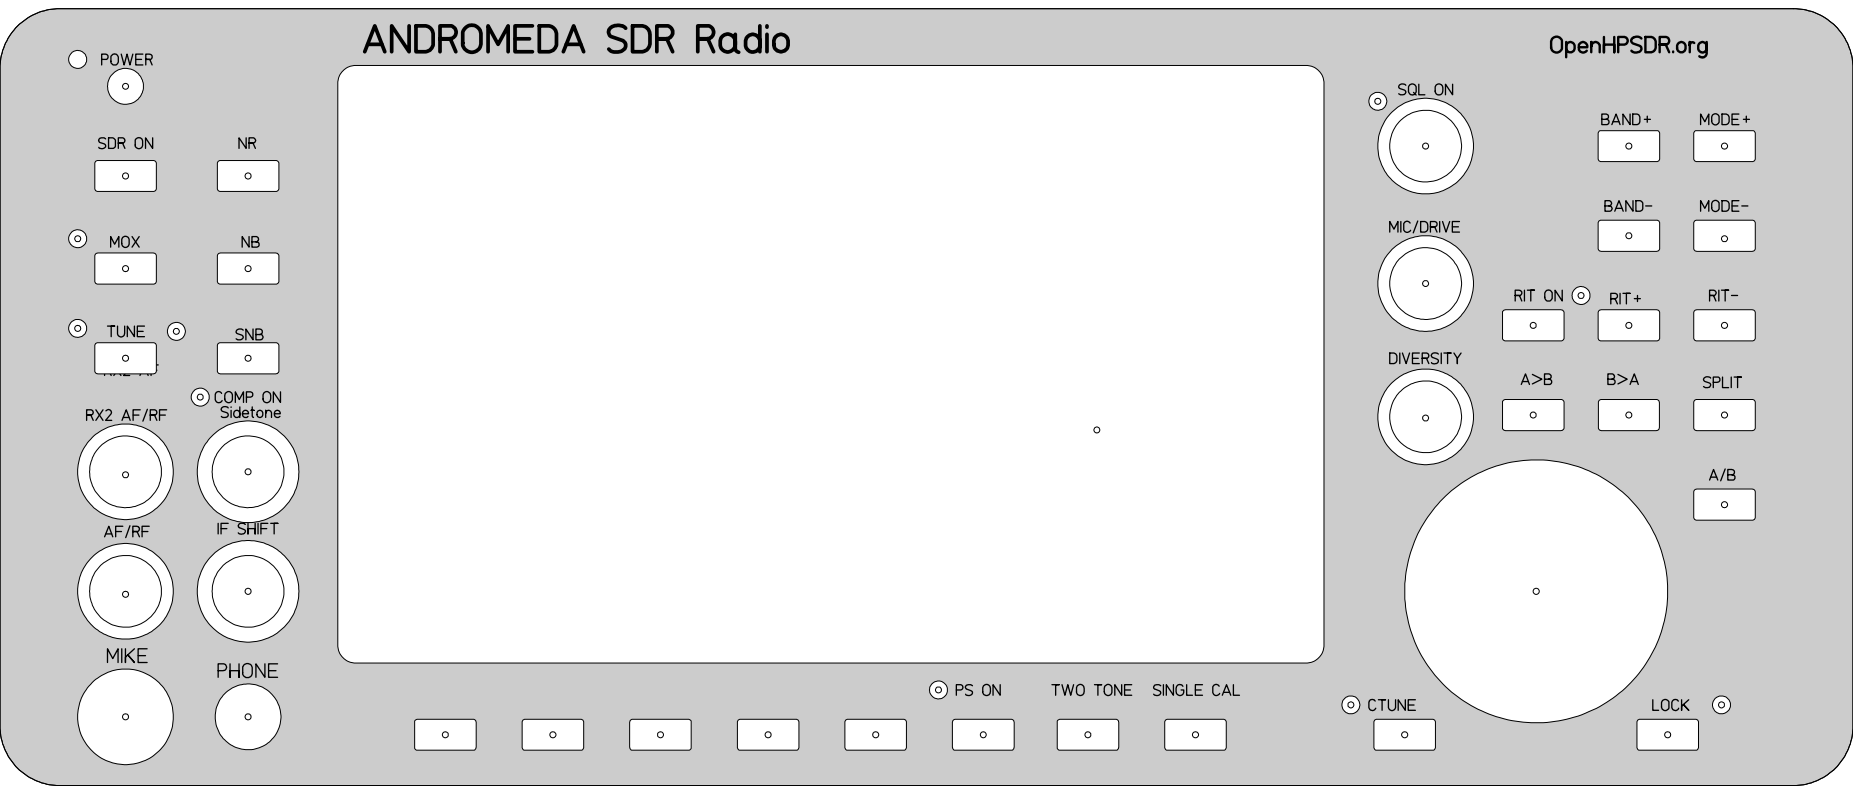
[picture p22: page 1]
