laurencebarker/Andromeda_front_panel/front panel/1st prototype hardware/Andromeda CAT Console_schematic prototype.pdf

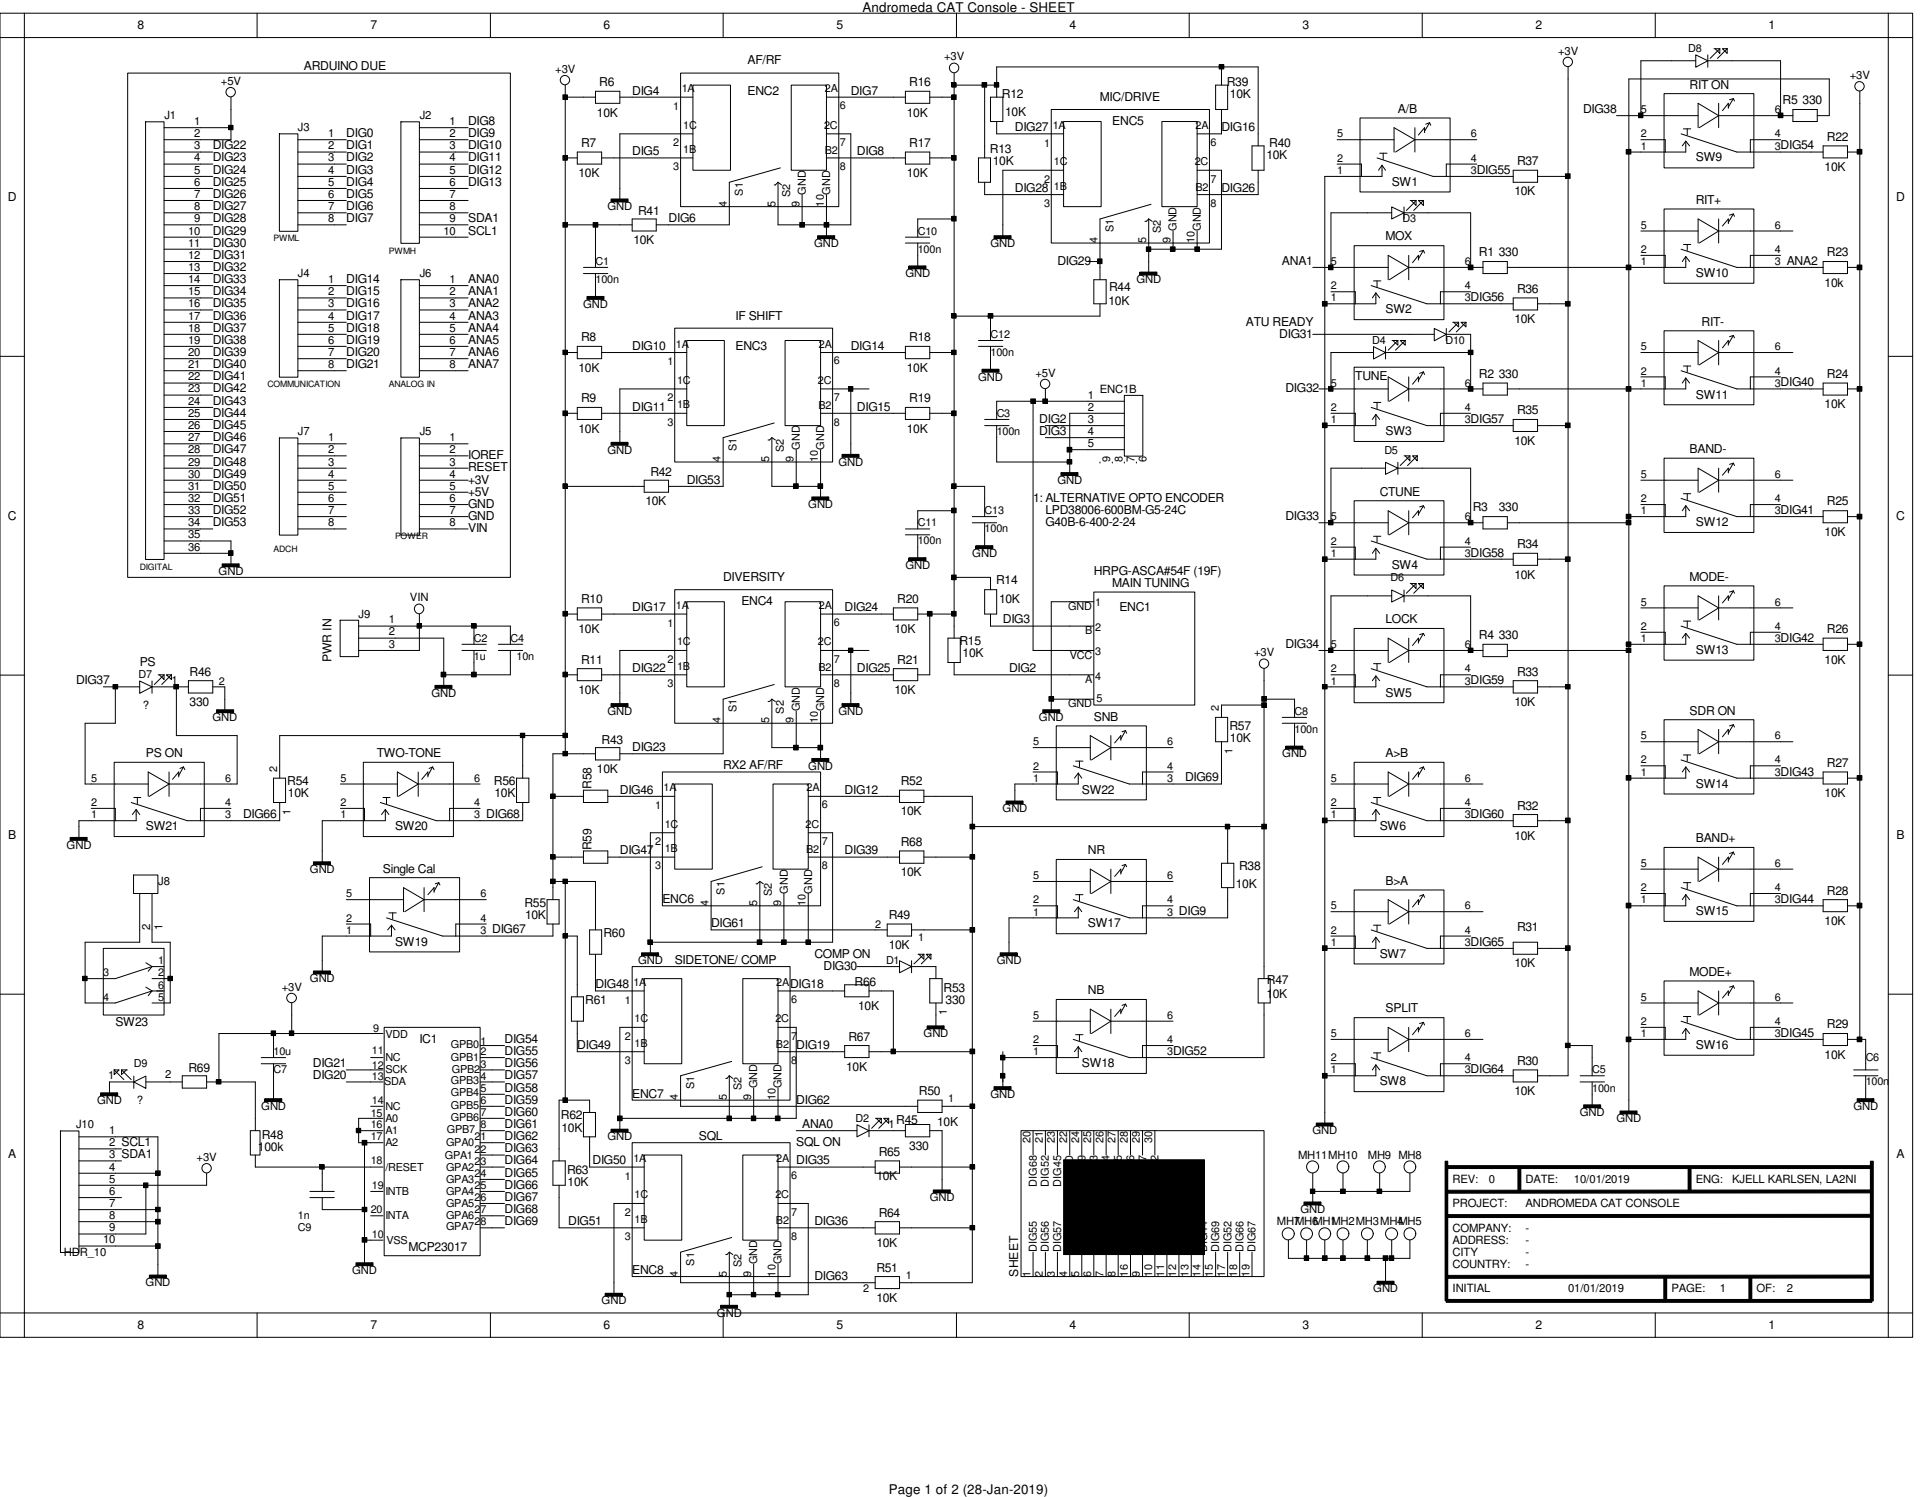
[picture p23: page 1]

Andromeda CAT Console - SHEET

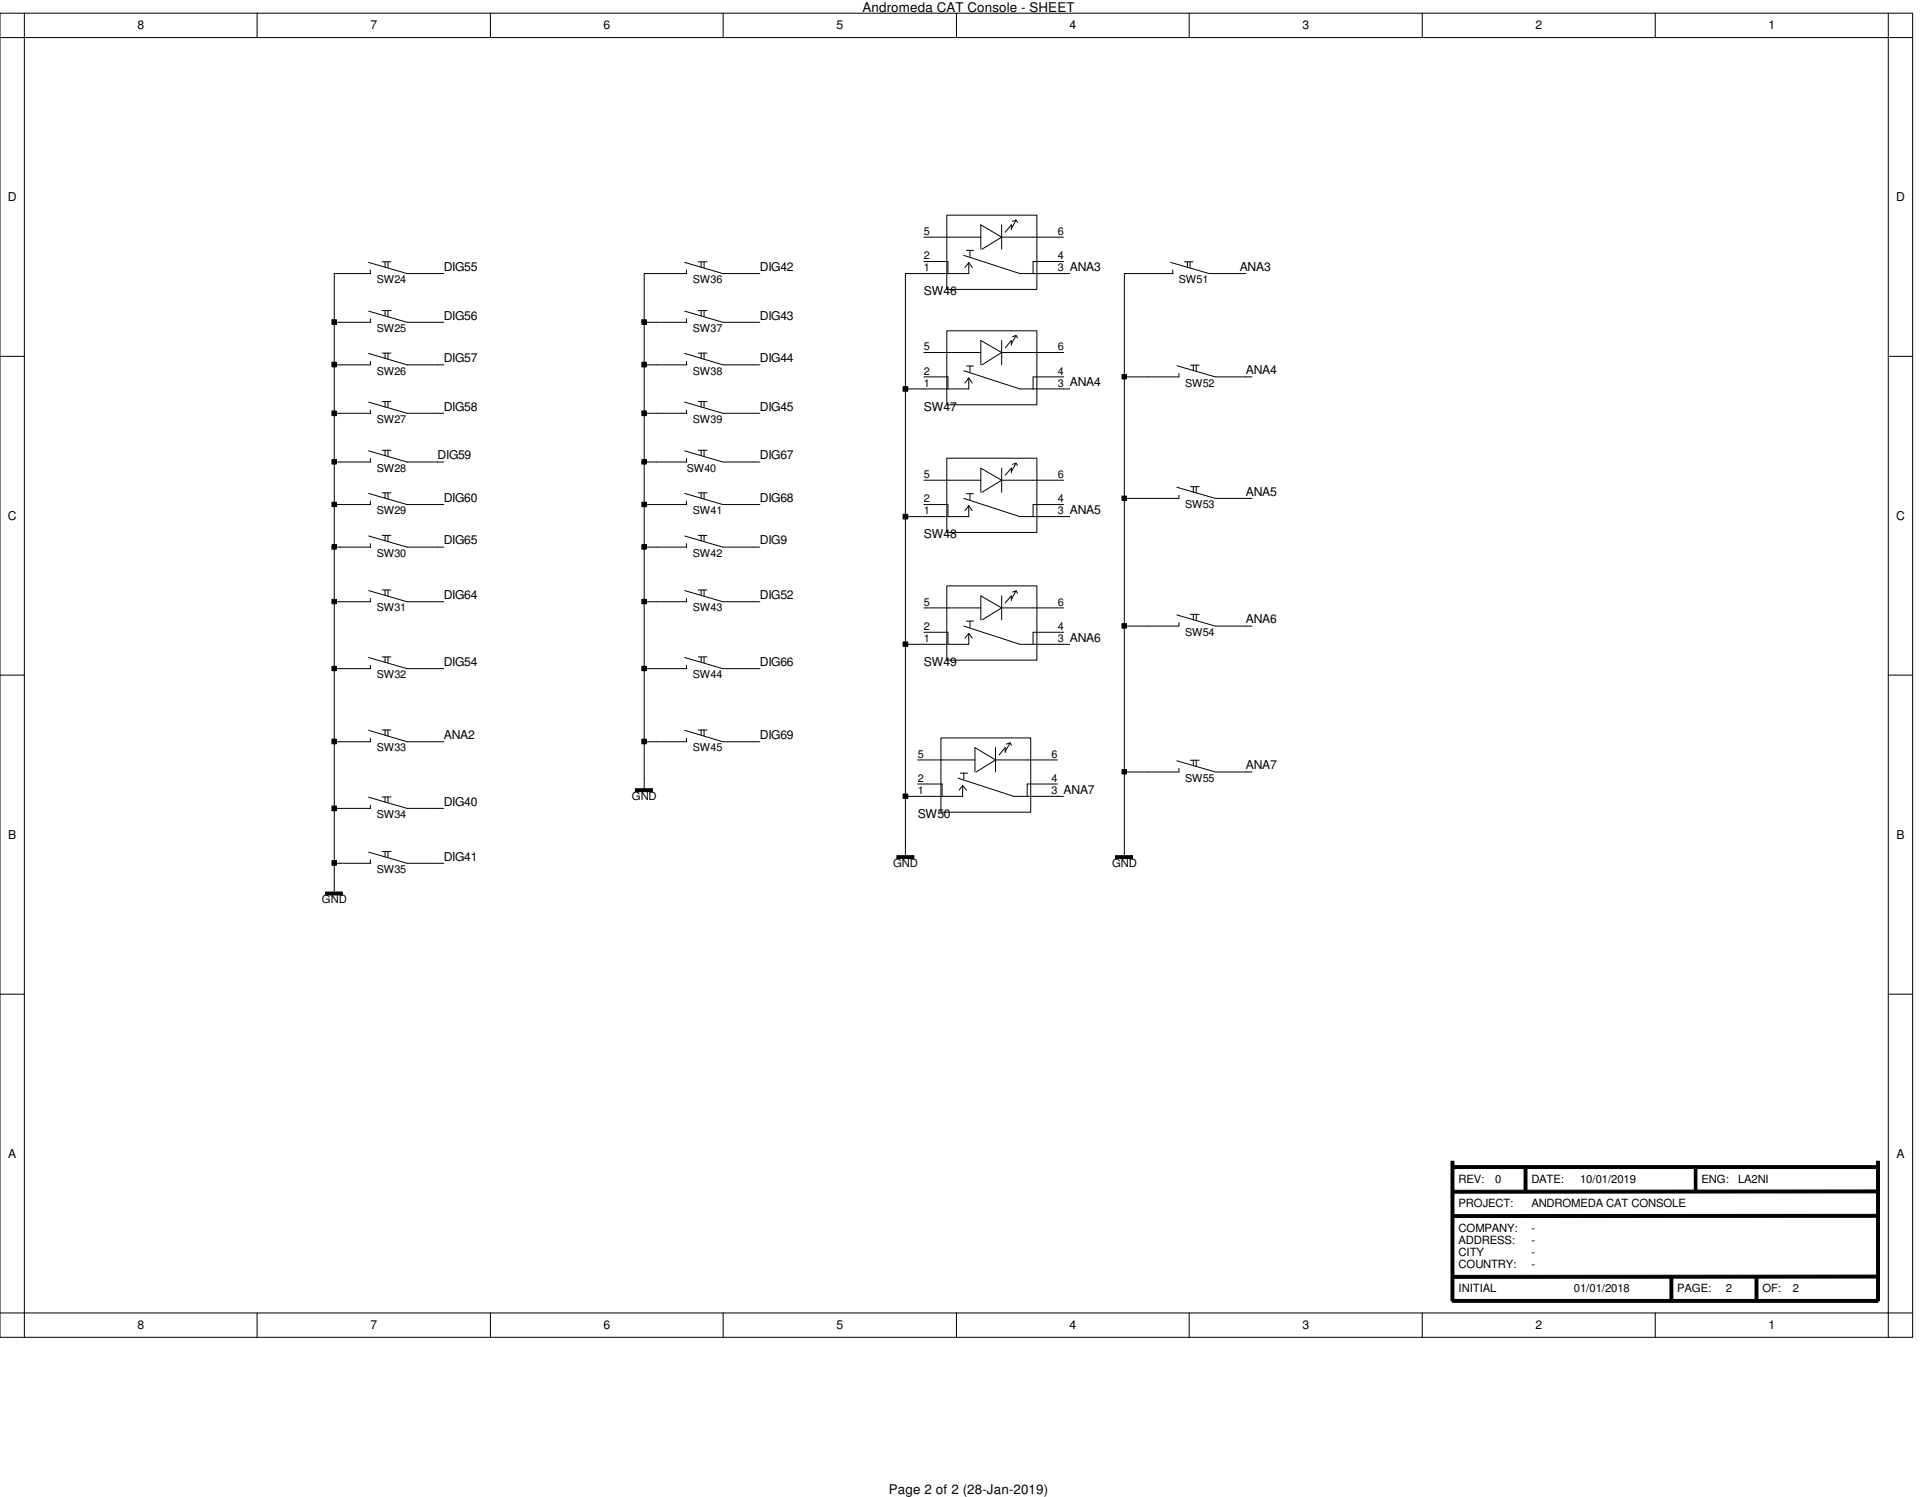
[picture p24: page 2]

Andromeda CAT Console - SHEET
