laurencebarker/Andromeda_front_panel/front panel/documentation/Andromeda SDR Radio v2 prototype_layout.pdf

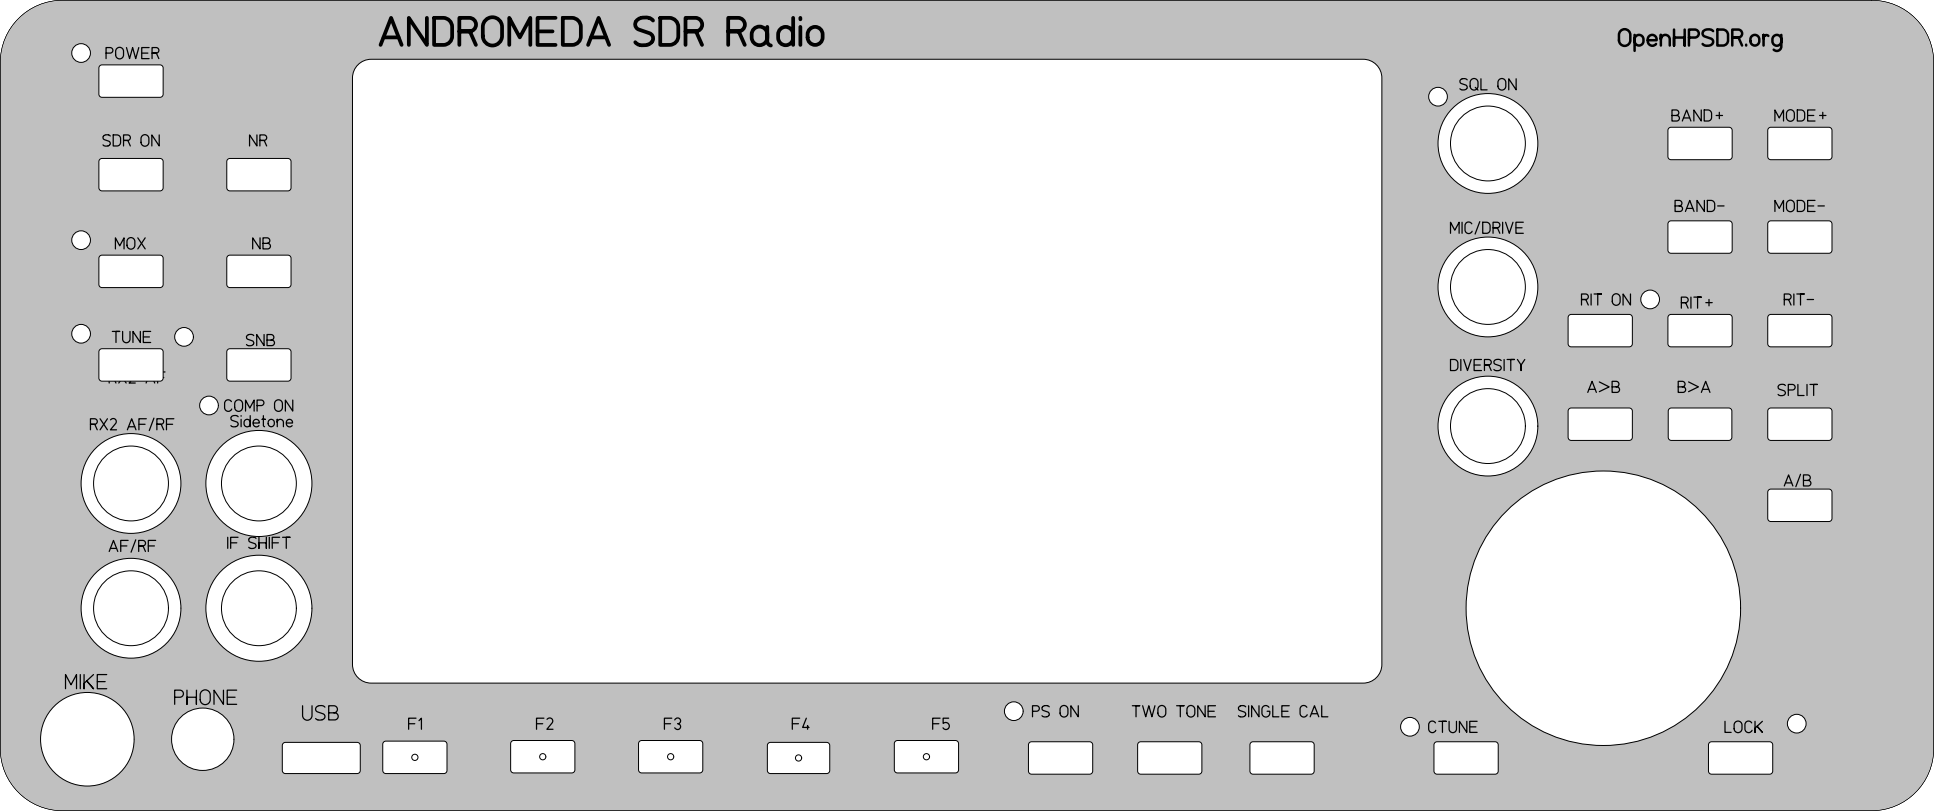
[picture p25: page 1]
