laurencebarker/Andromeda_front_panel/front panel/hardware rev 4/Andromeda Front Panel Rev5.pdf

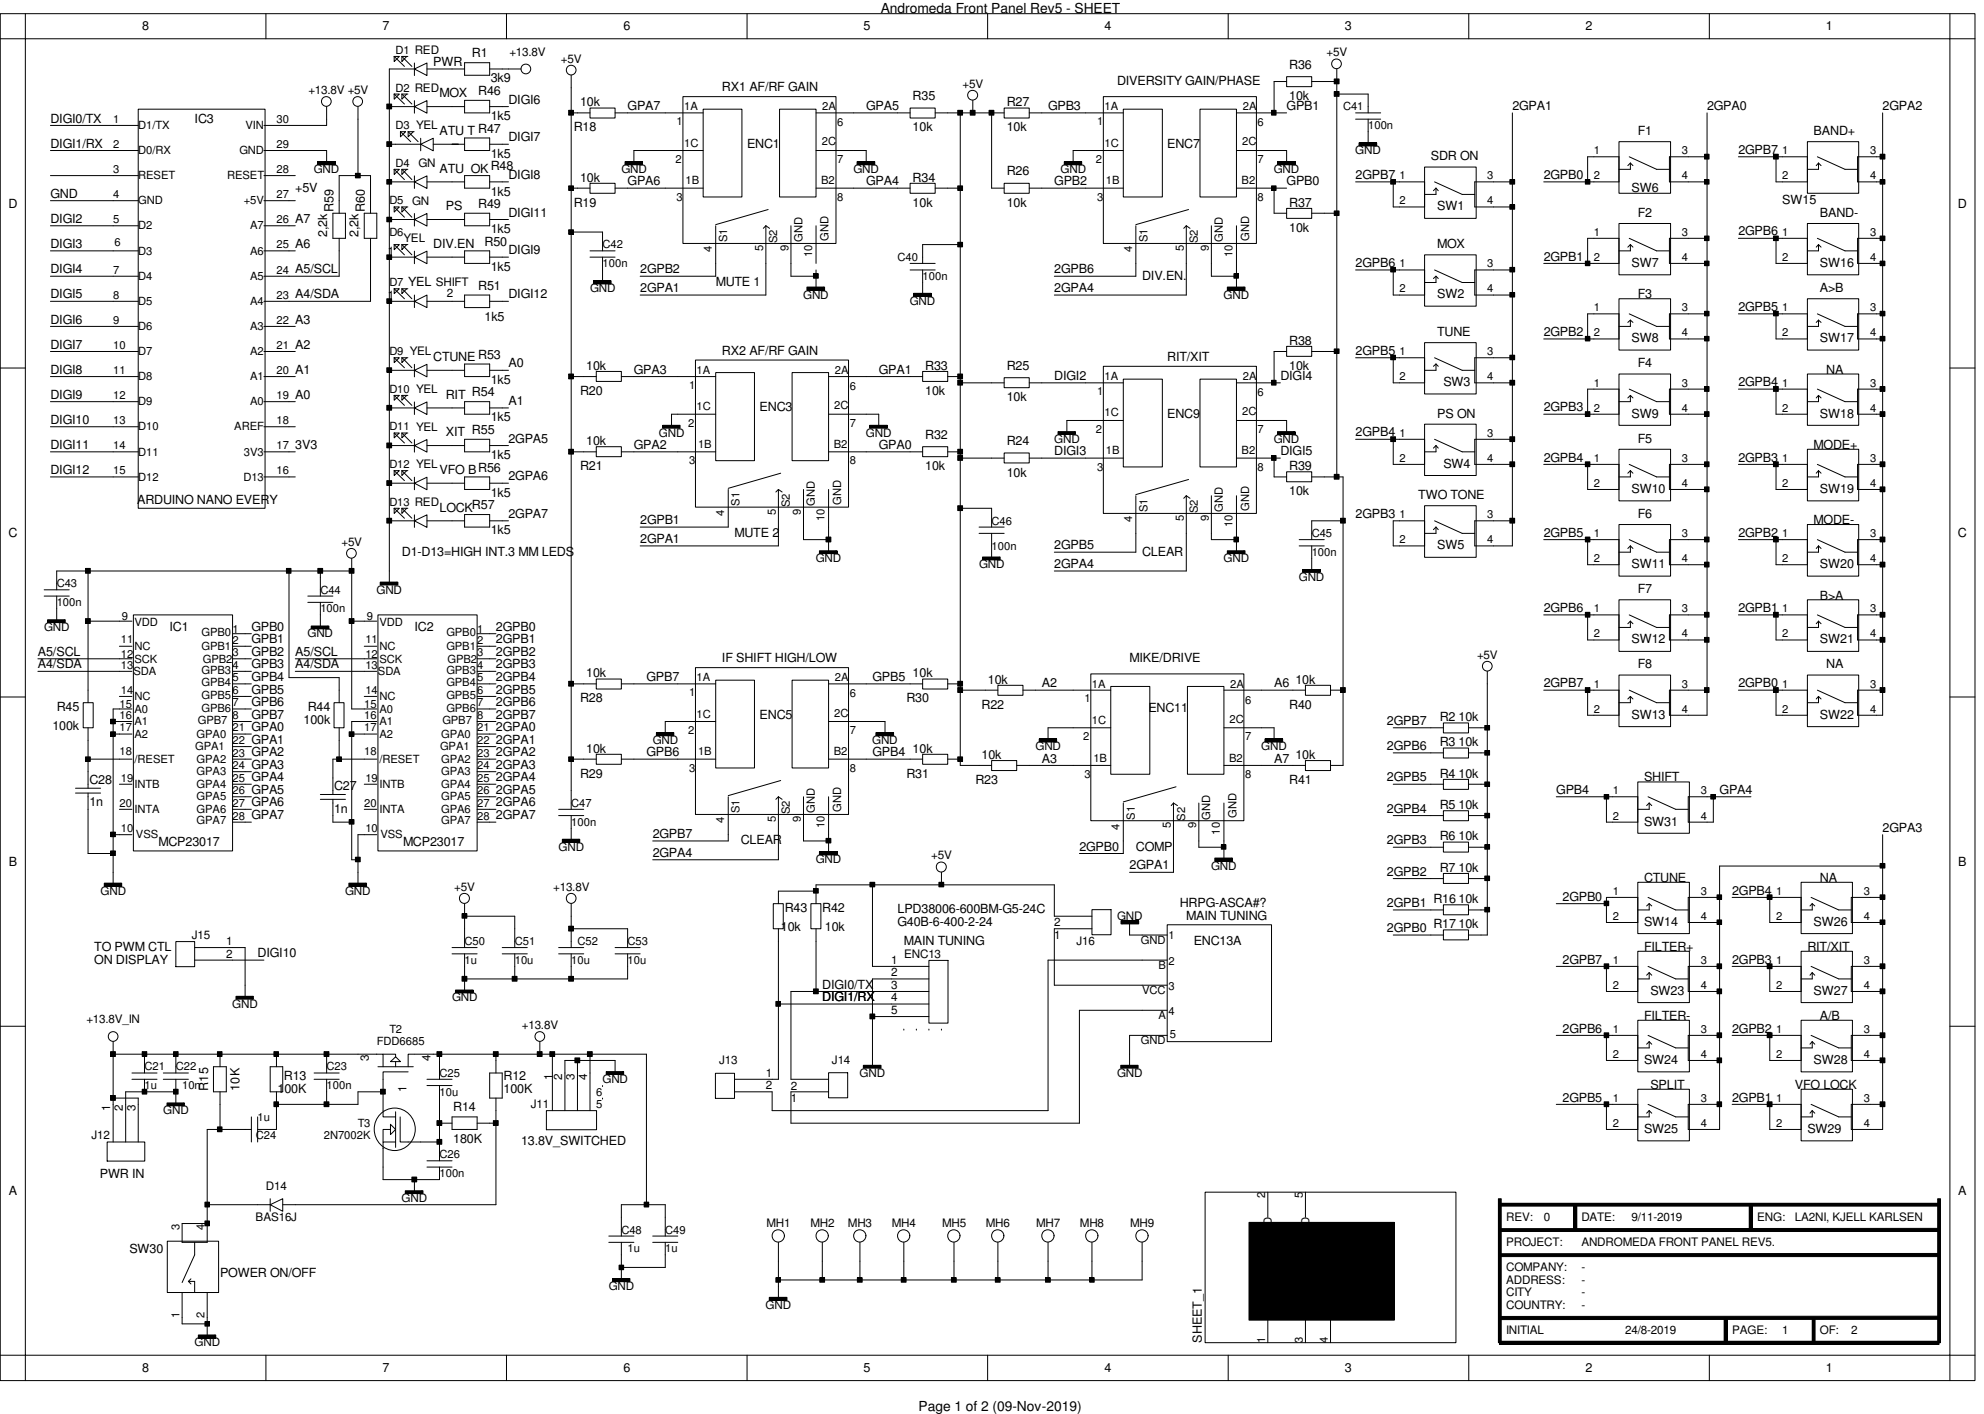
[picture p26: page 1]

Andromeda Front Panel Rev5 - SHEET

D1-D13=HIGH INT.3 MM LEDS

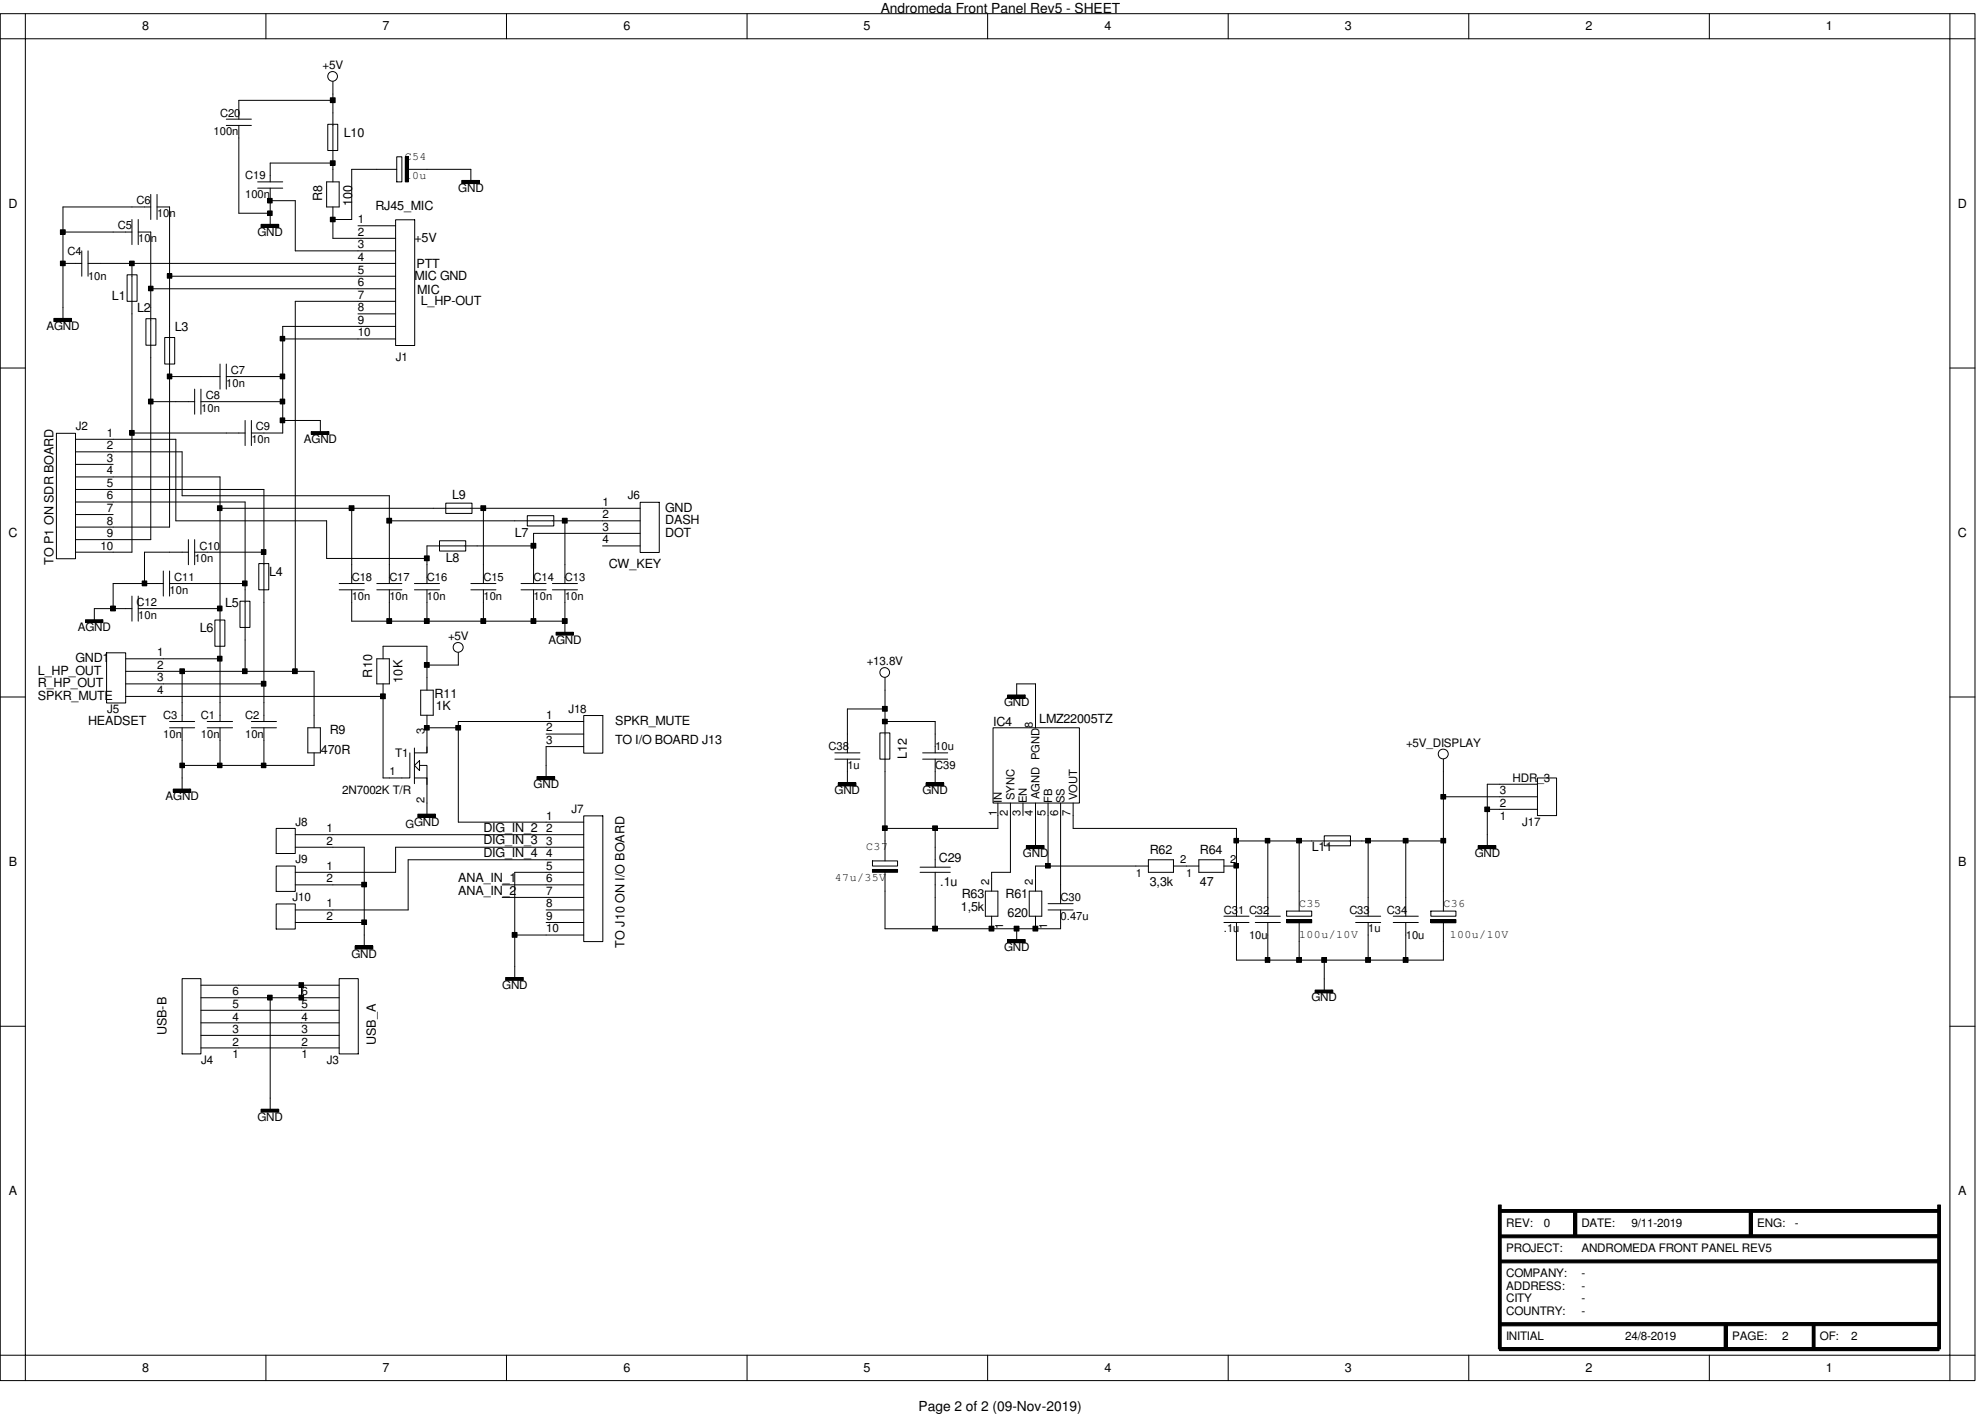
[picture p27: page 2]

Andromeda Front Panel Rev5 - SHEET

TO P1 ON SDR BOARD
