laurencebarker/Andromeda_front_panel/front panel/hardware rev 4/Andromeda Front Panel Rev4.pdf

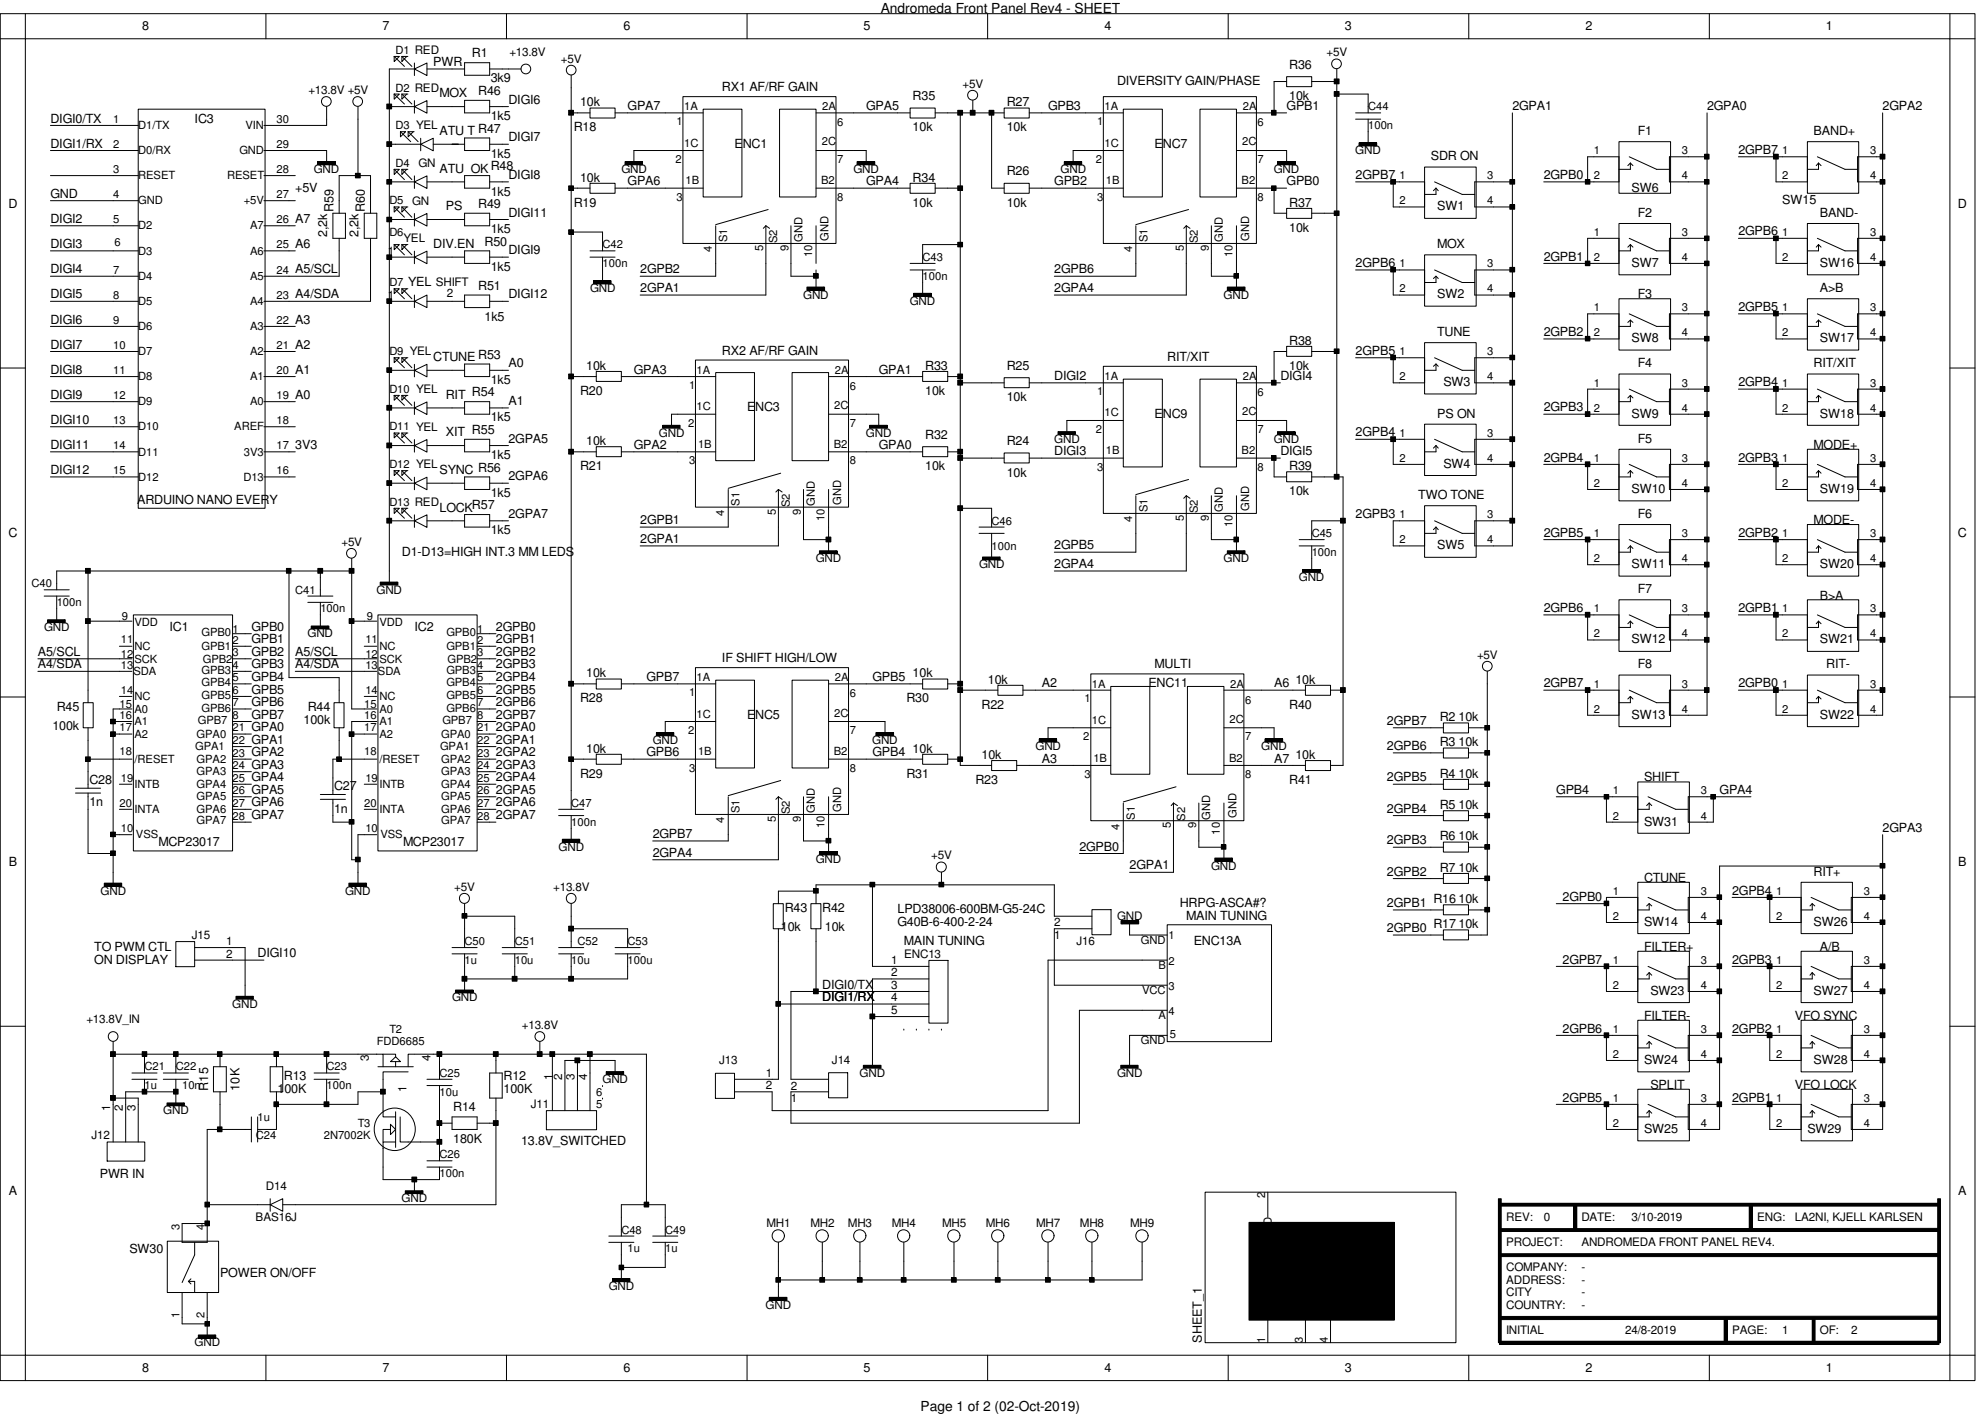
[picture p28: page 1]

Andromeda Front Panel Rev4 - SHEET

D1-D13=HIGH INT.3 MM LEDS

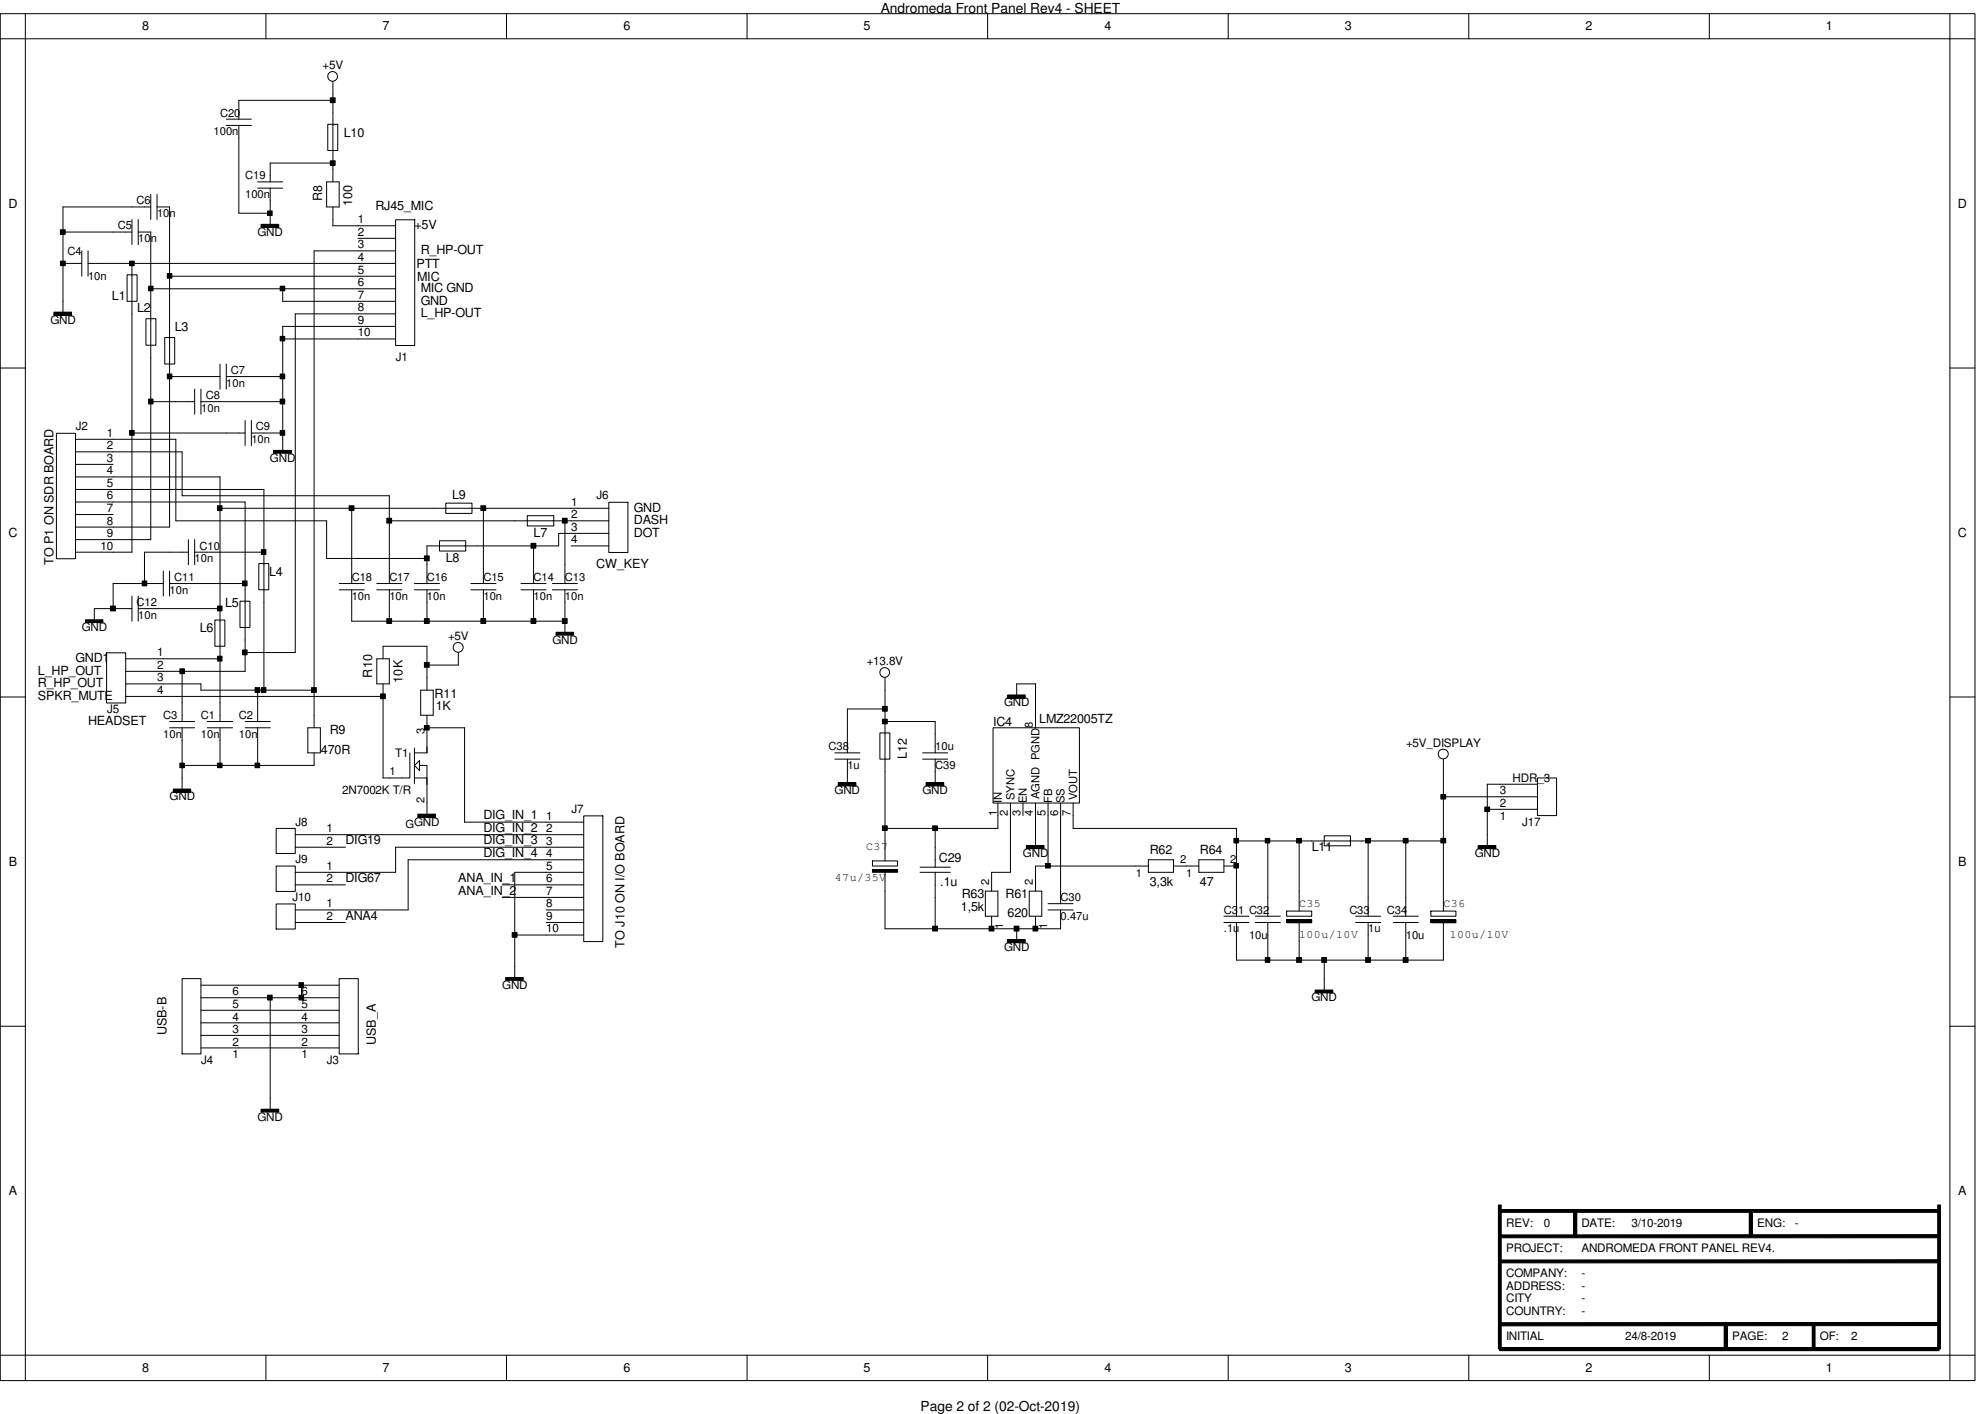
[picture p29: page 2]

Andromeda Front Panel Rev4 - SHEET

TO P1 ON SDR BOARD
