laurencebarker/Andromeda_front_panel/front panel/hardware rev 4/Andromeda Front Panel Rev4_290819.pdf

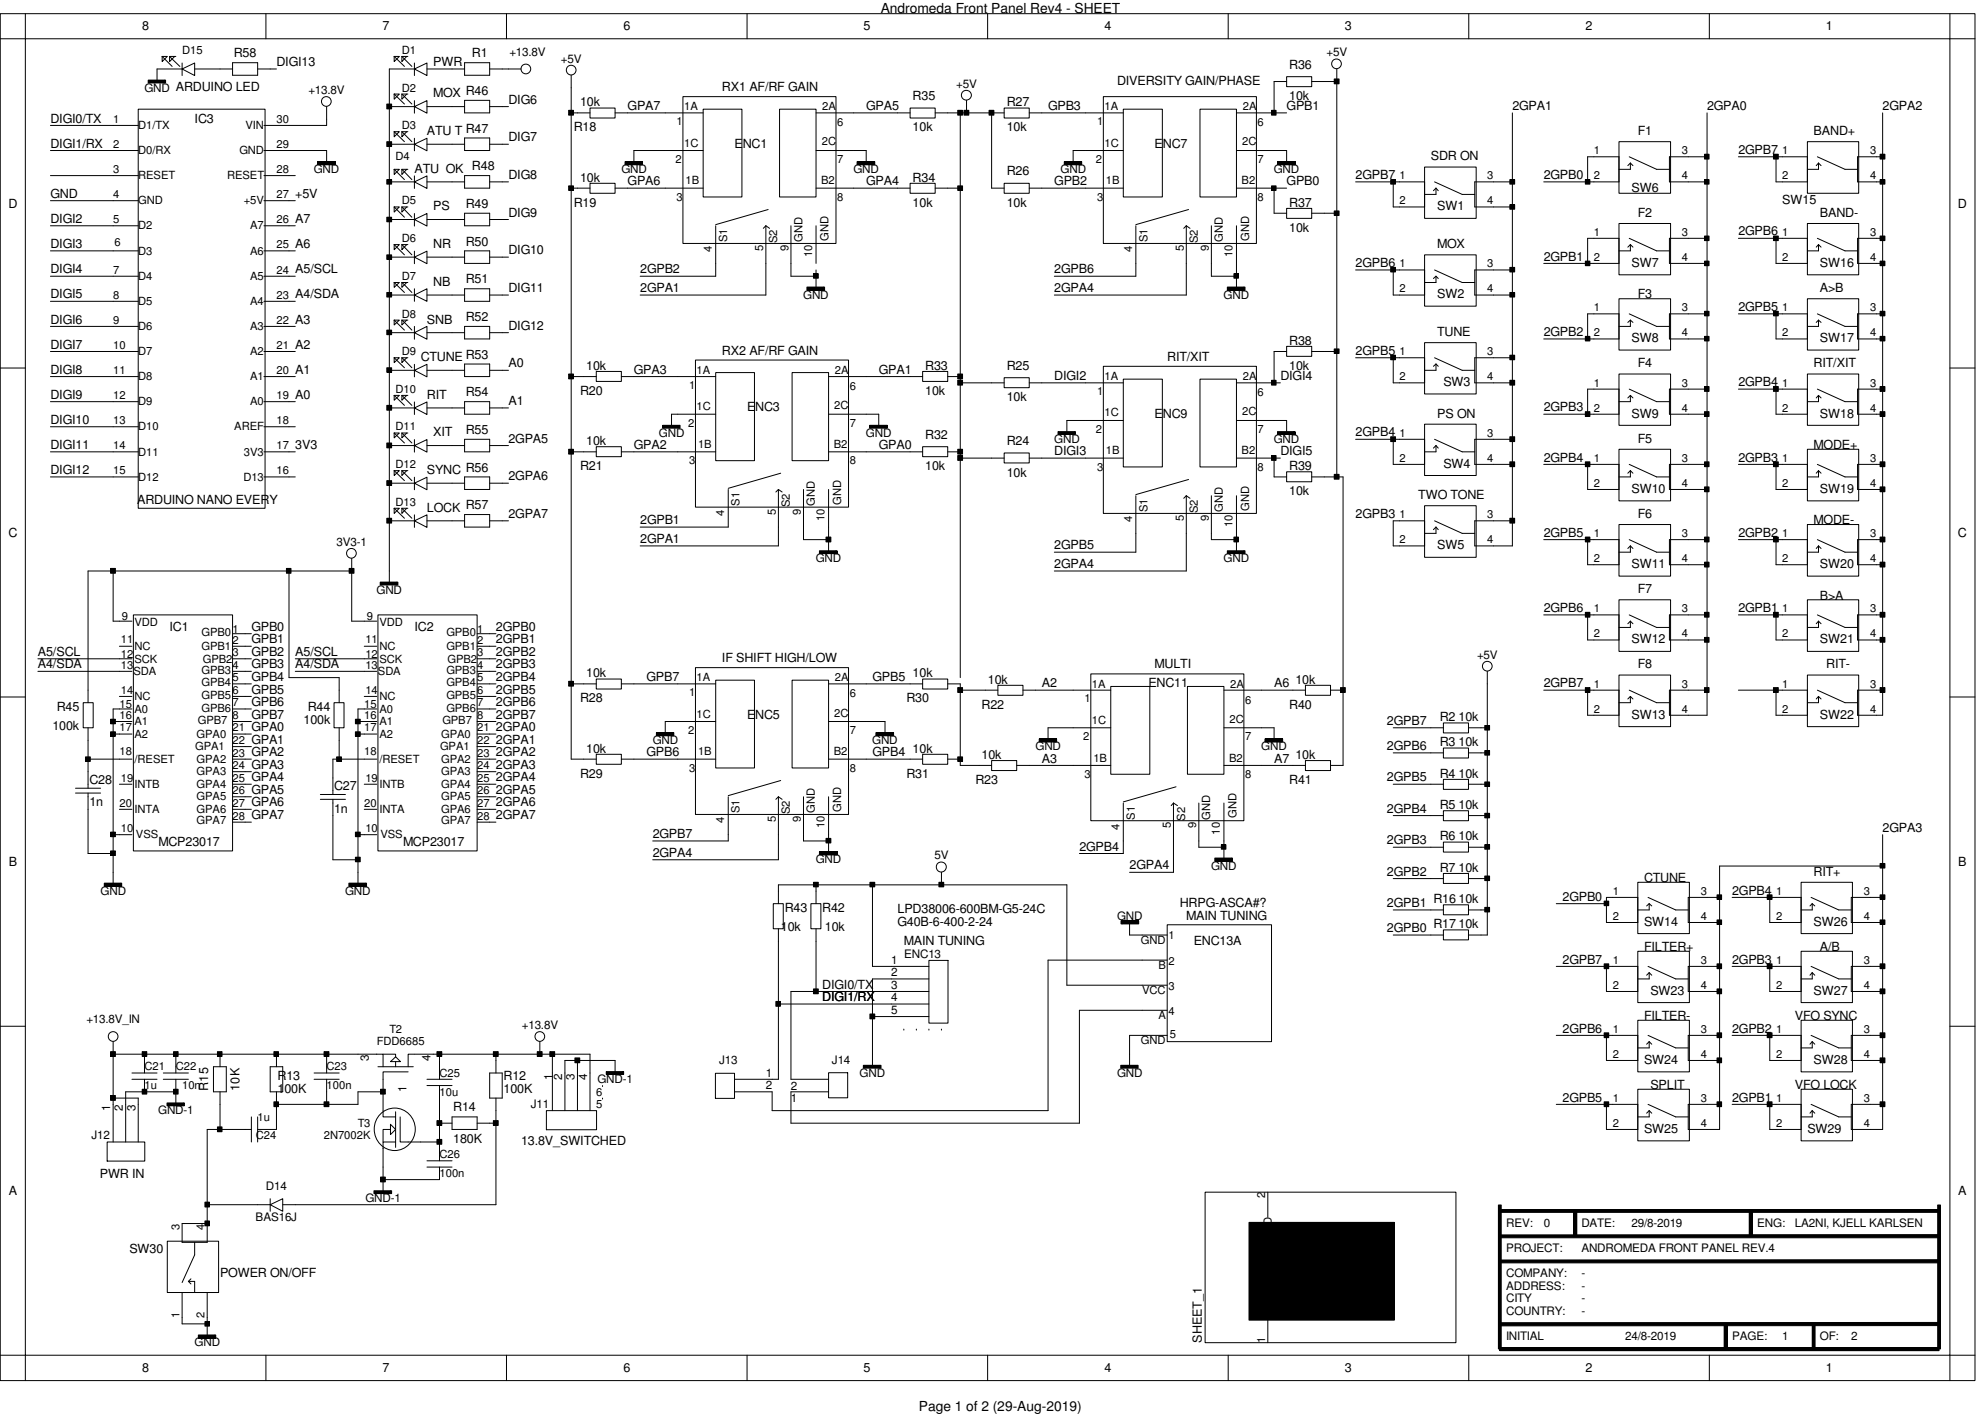
[picture p30: page 1]

Andromeda Front Panel Rev4 - SHEET

ANDROMEDA FRONT PANEL REV.4

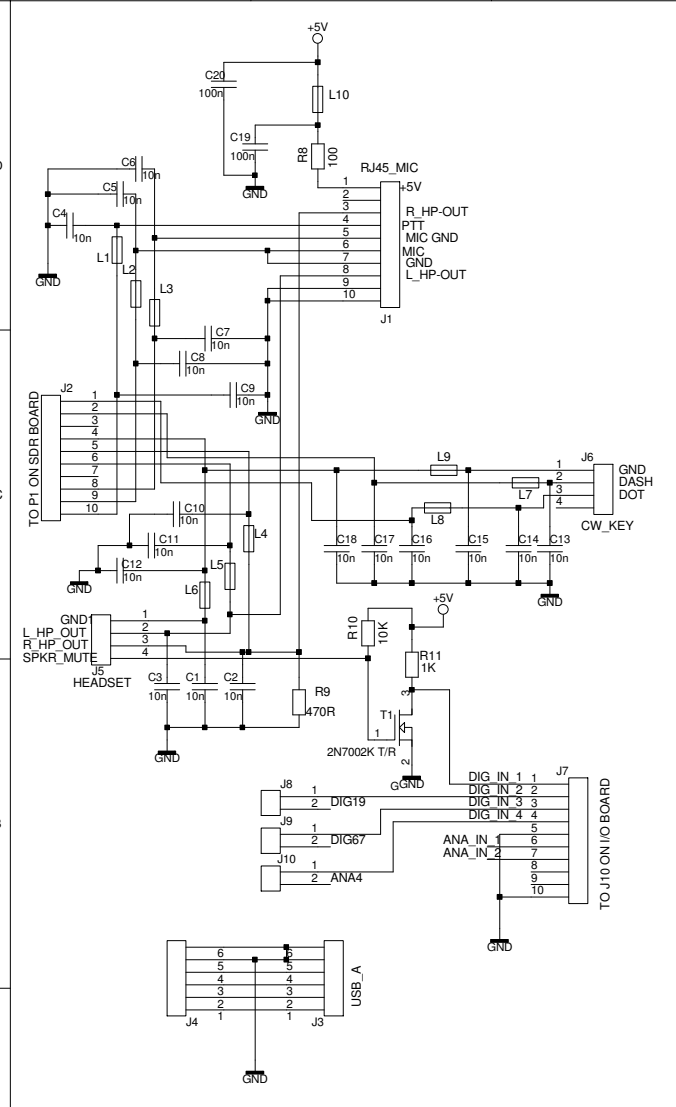
[picture p31: page 2]

Andromeda Front Panel Rev4 - SHEET

TO P1 ON SDR BOARD
