laurencebarker/Andromeda_front_panel/front panel/hardware/Andromeda CAT Console_rev3_Schema.pdf

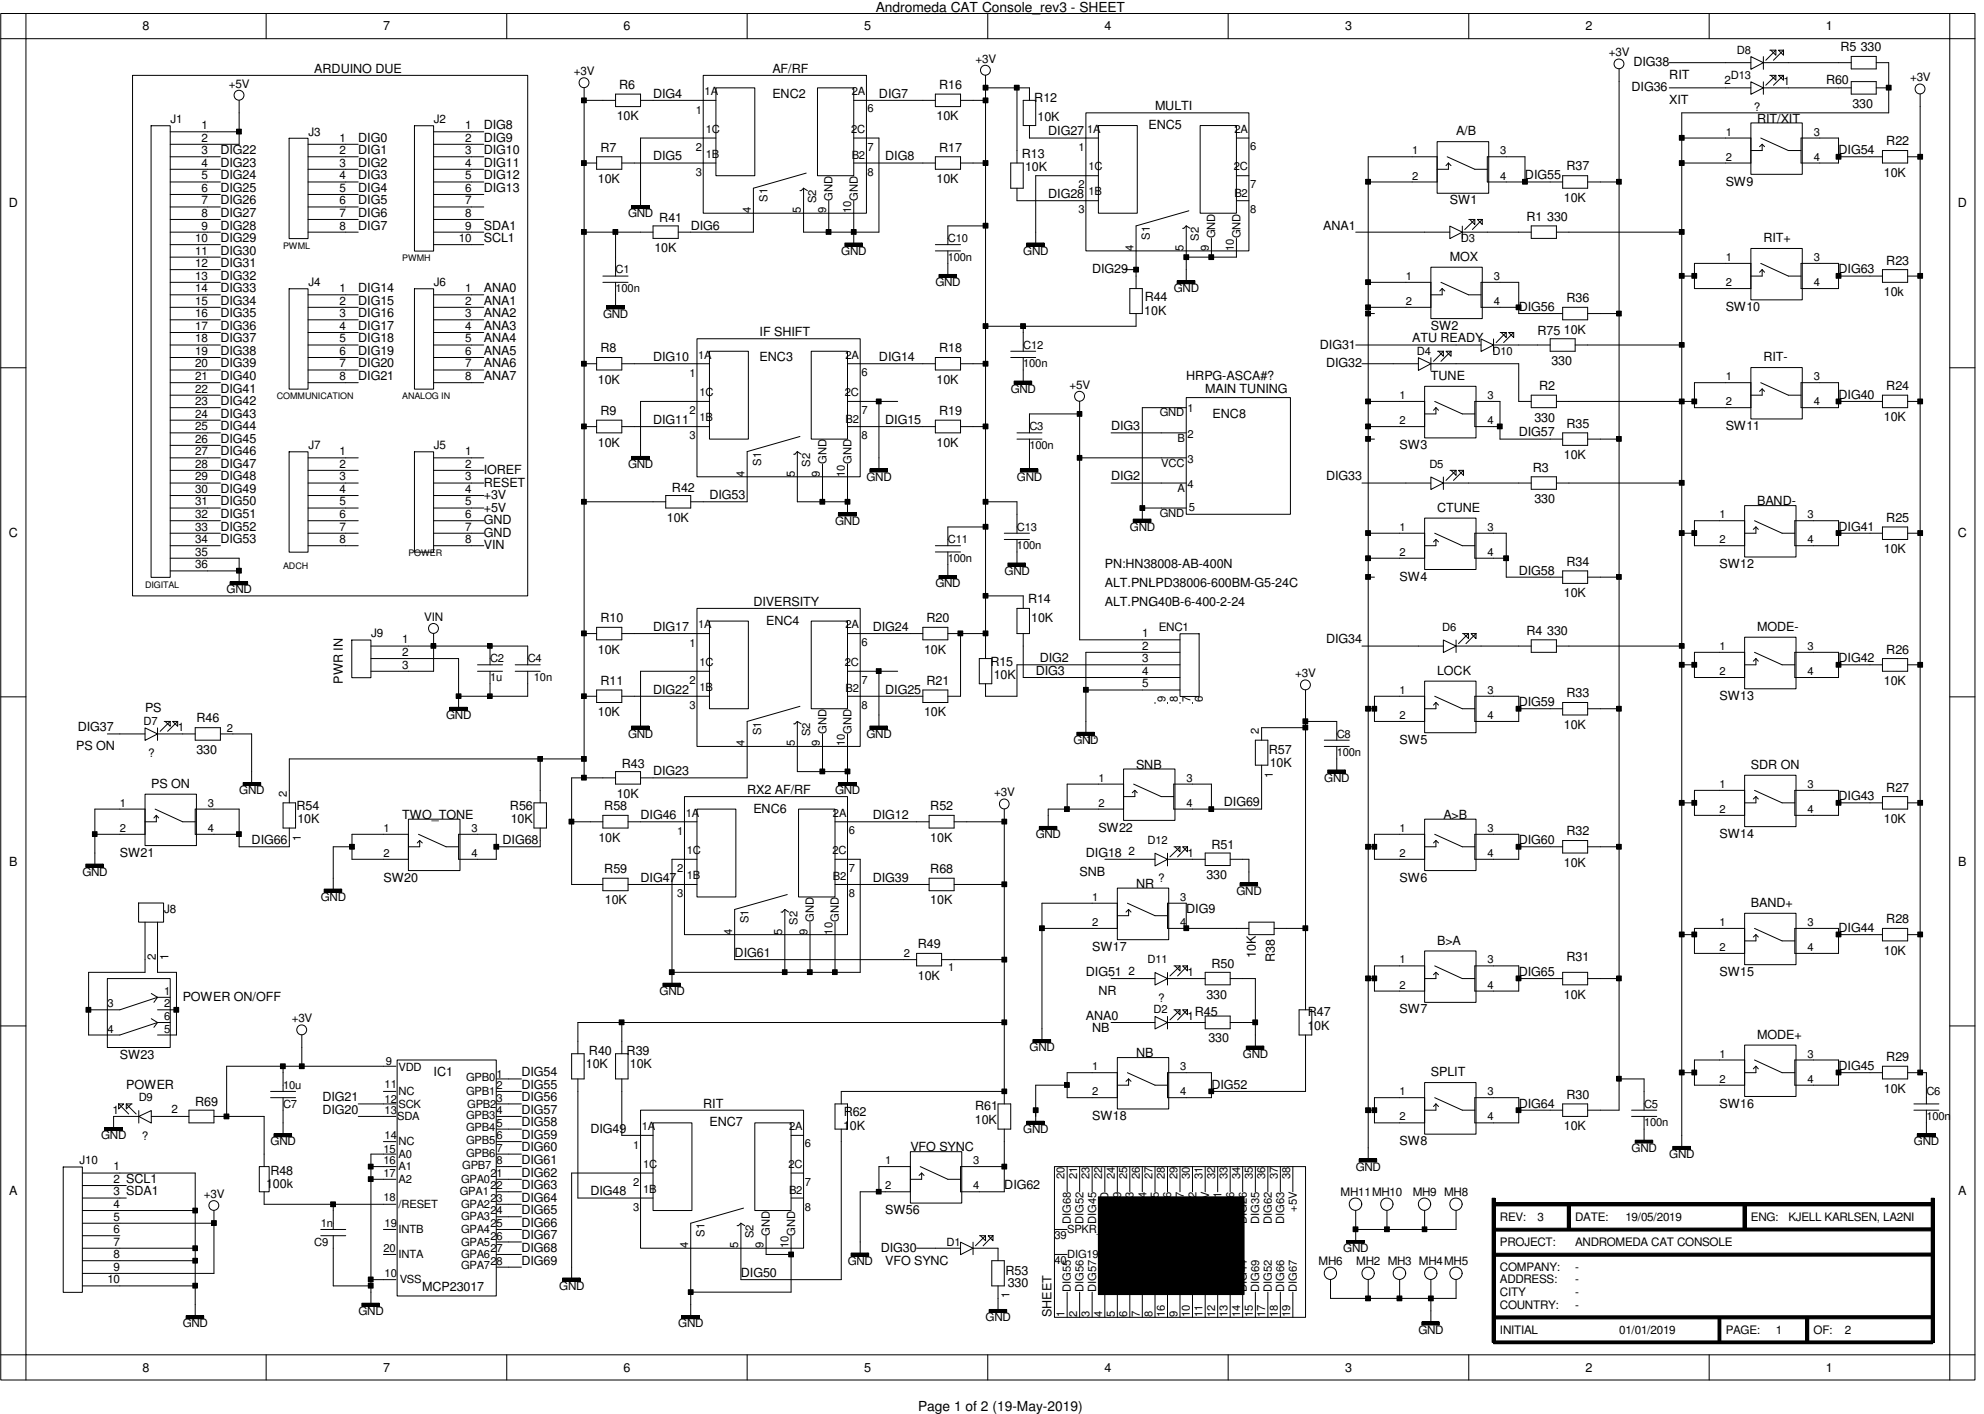
[picture p32: page 1]

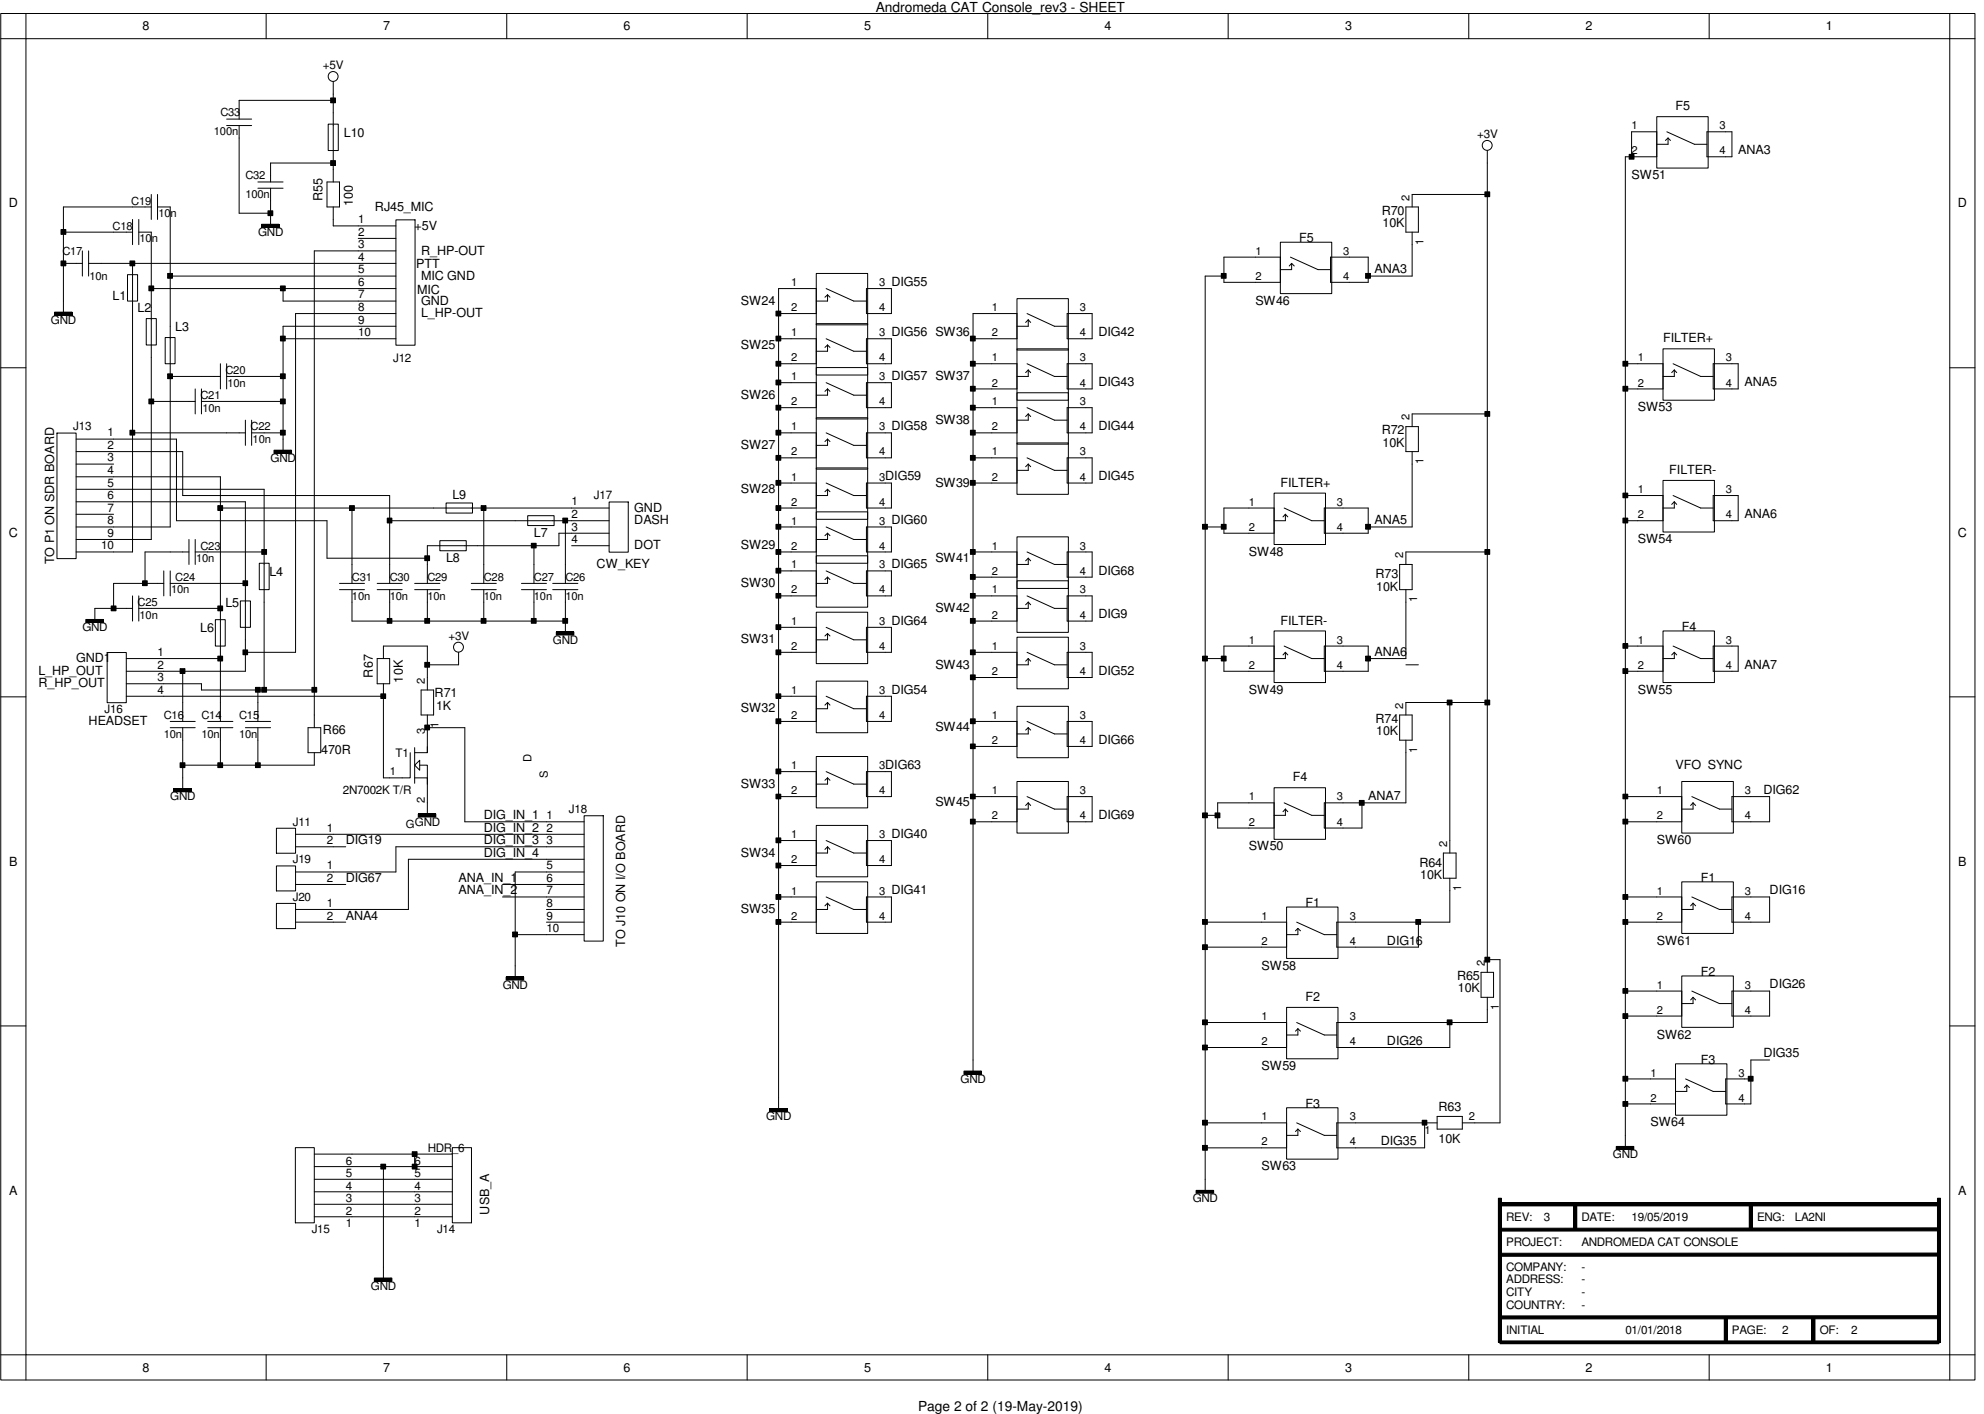
[picture p33: page 2]

TO P1 ON SDR BOARD
