laurencebarker/Andromeda_front_panel/front panel/hardware rev 4/Andromeda I-O Board_Schematic.pdf

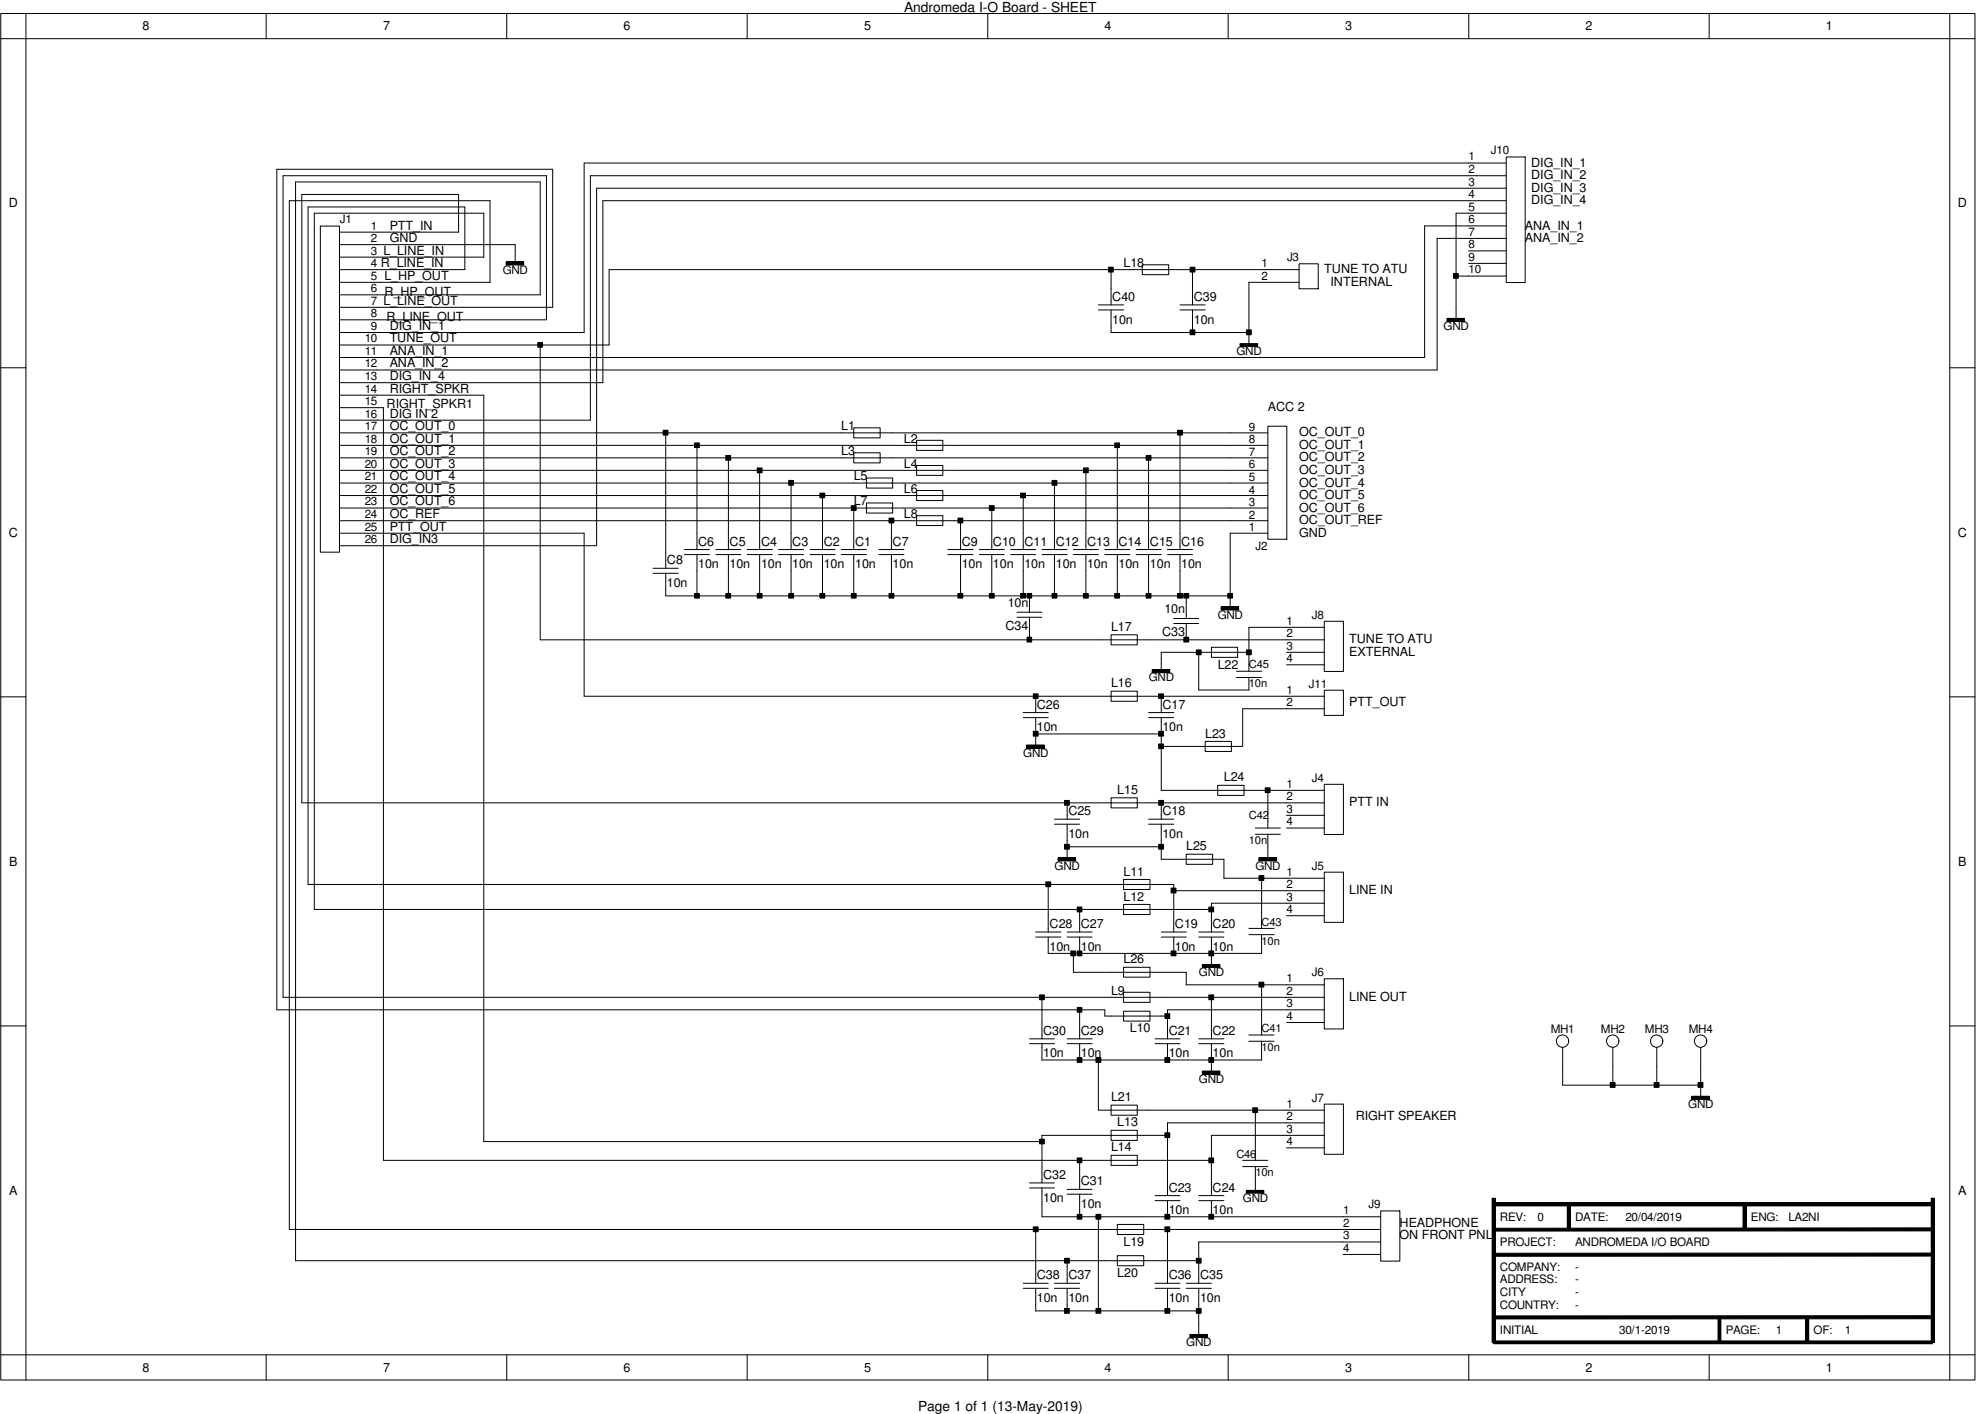
[picture p34: page 1]
