laurencebarker/Andromeda_front_panel/front panel/hardware/Andromeda SDR Radio_v3_layout.pdf

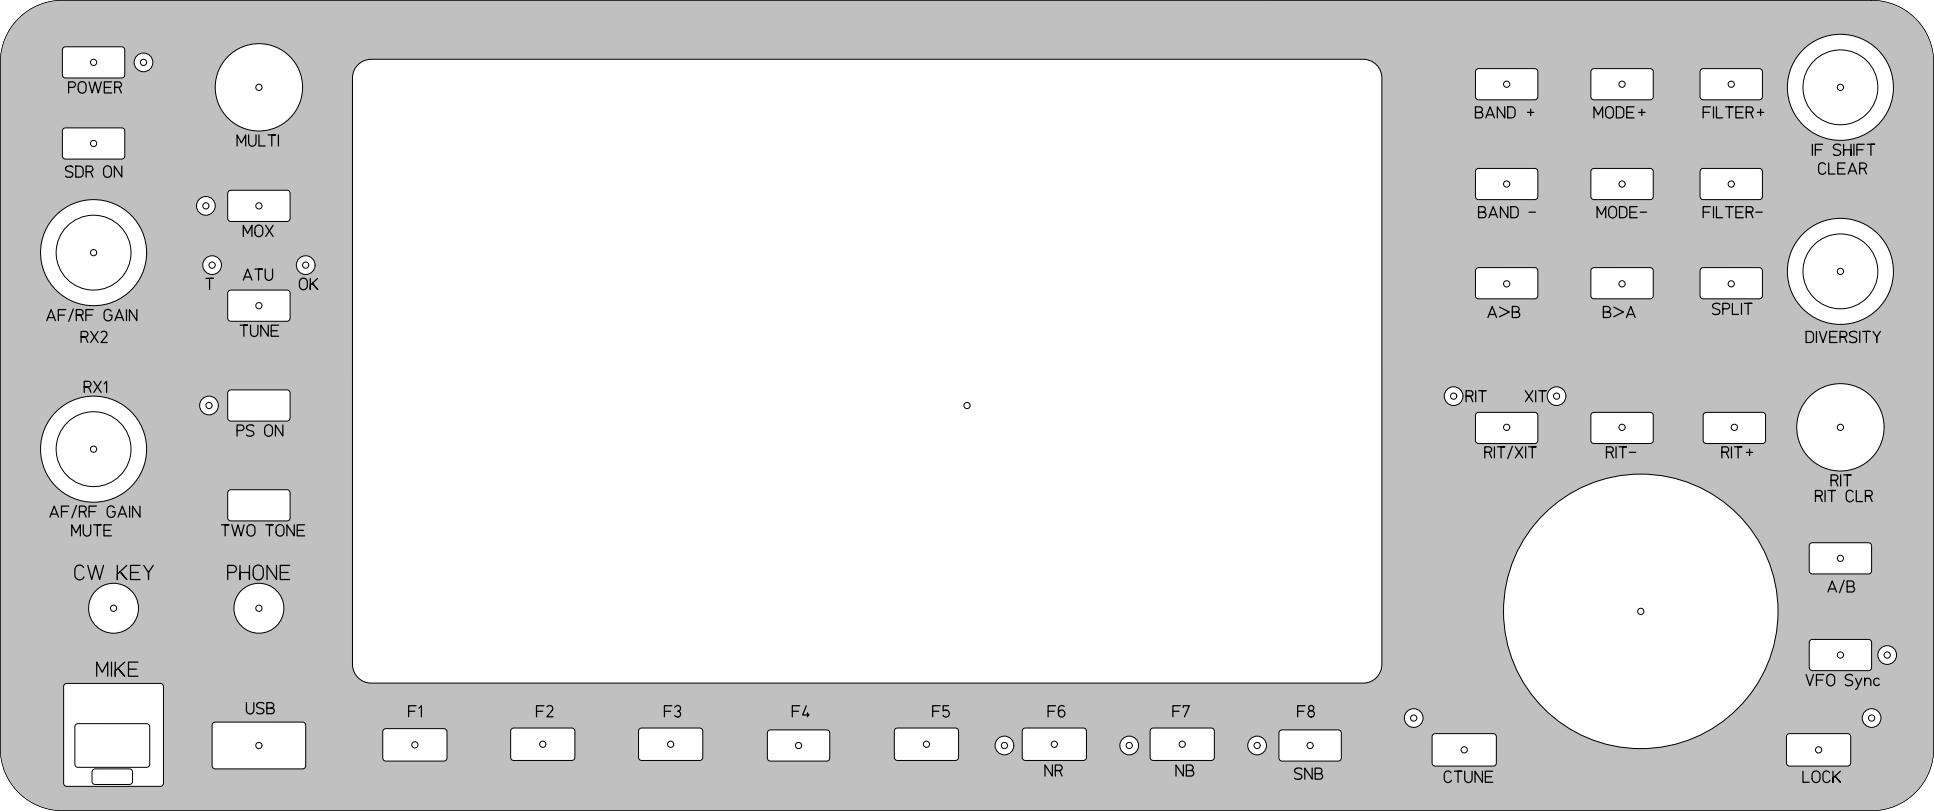
[picture p35: page 1]
