laurencebarker/Andromeda_front_panel/front panel/sketch/andromeda_front_panel/iopins.h

/////////////////////////////////////////////////////////////////////////
//
// Andromeda front panel controller by Laurence Barker G8NJJ
// this sketch provides a knob and switch interface through USB and CAT
// copyright (c) Laurence Barker G8NJJ 2019
//
// iopins.h
//
/////////////////////////////////////////////////////////////////////////

#ifndef __IOPINS_H
#define __IOPINS_H

#ifdef V3HARDWARE                       // Andromeda 2nd prototype
#define VPINVFOENCODERA 2
#define VPINVFOENCODERB 3

#define VPINENCODER1A 5           // encoder 2A
#define VPINENCODER1B 4

#define VPINENCODER2A 8           // encoder 2B on PCB
#define VPINENCODER2B 7

#define VPINENCODER3A 11          // encoder 3A
#define VPINENCODER3B 10

#define VPINENCODER4A 15          // encoder 3B
#define VPINENCODER4B 14

#define VPINENCODER5A 22          // encoder 4A
#define VPINENCODER5B 17

#define VPINENCODER6A 25          // encoder 4B
#define VPINENCODER6B 24

#define VPINENCODER7A 47          //encoder 6A
#define VPINENCODER7B 46

#define VPINENCODER8A 39          //encoder 6B
#define VPINENCODER8B 12

#define VPINENCODER9A 28          //encoder 5A
#define VPINENCODER9B 27

#define VPINENCODER10A 49         //encoder 7A
#define VPINENCODER10B 48

#define VPINBUTTON1 50
#define VPINBUTTON2 A3
#define VPINBUTTON3 A4
#define VPINBUTTON4 A5
#define VPINBUTTON5 A6
#define VPINBUTTON6 A7
#define VPINBUTTON7 6
#define VPINBUTTON8 9
#define VPINBUTTON9 23
#define VPINBUTTON10 29
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
//
#define VPININDICATOR1 34
#define VPININDICATOR2 37
#define VPININDICATOR3 A1
#define VPININDICATOR4 32
#define VPININDICATOR5 33
#define VPININDICATOR6 30
#define VPININDICATOR7 A0
#define VPININDICATOR8 38
#define VPININDICATOR9 31
#endif


#define VPINORANGELED 13

#endif //not defined
