laurencebarker/Andromeda_front_panel/front panel/Arduino Nano Every Sketch/andromeda_front_panel_nano/globalinclude.h

/////////////////////////////////////////////////////////////////////////
//
// Andromeda front panel controller by Laurence Barker G8NJJ
// this sketch provides a knob and switch interface through USB and CAT
// copyright (c) Laurence Barker G8NJJ 2019
//
// globalinclude.h
// this file holds #defines for conditional compilation
/////////////////////////////////////////////////////////////////////////
#ifndef __globalinclude_h
#define __globalinclude_h


//
// encoder type: for ball bearing encoder, the parameter should be defined
//
//#define HIRESOPTICALENCODER 1

//
// hardware and software version: send back to console on request
//
#define SWVERSION 6
#define HWVERSION 1

//
// product iD: send back to console on request
// 1=Andromeda front panel
// 2 = Aries ATU
//
#define PRODUCTID 1


#endif      // file sentry
