laurencebarker/Andromeda_front_panel/front panel/Arduino Nano Every Sketch/andromeda_front_panel_nano/tiger.h

/////////////////////////////////////////////////////////////////////////
//
// Andromeda front panel controller by Laurence Barker G8NJJ
// this sketch provides a knob and switch interface through USB and CAT
// copyright (c) Laurence Barker G8NJJ 2019
//
// tiger.h
// this file holds the CAT parsing code
// large CAT file = tiger....
/////////////////////////////////////////////////////////////////////////
#ifndef __tiger_h
#define __tiger_h
#include <Arduino.h>
#include "types.h"


//
// firstly an enumerated list of all of the CAT commands
// ordered as per documentation, not alphsabetically!
enum ECATCommands
{
  eZZZD,                          // VFO steps down
  eZZZU,                          // VFO steps up
  eZZZE,                          // other encoder
  eZZZP,                          // pushbutton
  eZZZI,                          // indicator
  eZZZS,                          // s/w version
  eZZZX,
  eNoCommand                      // this is an exception condition
};


typedef enum
{
  eNone,                          // no parameter
  eBool,                          // boolean parameter
  eNum,                           // numeric parameter     
  eStr                            // string parameter
}ERXParamType;



//
// this struct holds a record to describe one CAT command
//
struct SCATCommands
{
  char* CATString;                // eg "ZZAR"
  ERXParamType RXType;            // type of parameter expected on receive
  long MinParamValue;             // eg "-999"
  long MaxParamValue;             // eg "9999"
  byte NumParams;                 // number of parameter bytes in a "set" command
  bool AlwaysSigned;              // true if the param version should always have a sign
};



extern SCATCommands GCATCommands[];

//
// initialise CAT handler
//
void InitCAT(void);


//
// ScanParseSerial()
// scans input serial stream for characters; parses complete commands
// when it finds one
//
void ScanParseSerial(void);



//
// ParseCATCmd()
// Parse a single command in the local input buffer
// process it if it is a valid command
//
void ParseCATCmd(void);

//
// create CAT message:
// this creates a "basic" CAT command with no parameter
// (for example to send a "get" command)
//
void MakeCATMessageNoParam(ECATCommands Cmd);


//
// make a CAT command with a numeric parameter
//
void MakeCATMessageNumeric(ECATCommands Cmd, long Param);

//
// make a CAT command with a bool parameter
//
void MakeCATMessageBool(ECATCommands Cmd, bool Param);

//
// make a CAT command with a string parameter
// the string is truncated if too long, or padded with spaces if too short
//
void MakeCATMessageString(ECATCommands Cmd, char* Param);



#endif //not defined
