laurencebarker/Andromeda_front_panel/front panel/Arduino Nano Every Sketch/andromeda_front_panel_nano/types.h

/////////////////////////////////////////////////////////////////////////
//
// Andromeda front panel controller by Laurence Barker G8NJJ
// this sketch provides a knob and switch interface through USB and CAT
// copyright (c) Laurence Barker G8NJJ 2019
//
// types.h
//
/////////////////////////////////////////////////////////////////////////

#ifndef __TYPES_H
#define __TYPES_H

//
// define the numbers of controls available
//
#define VMAXINDICATORS 11
#define VMAXENCODERS 12             // configurable, not including VFO
#define VMAXBUTTONS 34

//
// ID of encoder and pushbutton that operate PWM if the button pressed
//
#define VPWMENCODER 0               // encoder 1
#define VPWMSCANCODE 10             // encoder 1 press


#endif //not defined
