laurencebarker/Andromeda_front_panel/(commit log)

2019-09-08 1st build new controller with switch matrix
2019-10-12 added h/w version; PWM control; tidy up
2019-11-17 updates after testing 1st prototype PCB:
    swapped LED 4&5, to make more geographical
    pushbutton scan codes are now more geographically laid out of the PCB
    [andromeda and pihpsdr mk2 BOM.xlsx]
2019-11-18 code with remapped keys from 1st prototype PCB
2019-11-29 updated documentation
    [andromeda and pihpsdr mk2 BOM.xlsx]
2019-12-04 fixed issue to delete control characters from CAT input string
    [tiger.cpp]
2019-12-15 display brightness PWM ramp down
2019-12-16 fix bug with debug statement left in code
    [led.cpp]
2019-12-21 conditional compilation for high resolution encoders
2019-12-31 change TCA to get 8KHz PRF PWM
2020-07-01 documentation update
    [thetis fast tune calculator.xlsx]
2020-09-26 Update display PWM for FET driver
    polarity of the display brightness control reversed to allow a FET driver
    [led.cpp]
2020-10-04 documentation for PCB modifications
    shows changes required to add backwired FET on the PCB for PWM brightness
    shows change required to correct the Yaesu microphone pinout
2020-12-07 updated BOM
    [ANDROMEDA BOM 5F.xls]
2023-01-09 updated instructions for using Arduino IDE
